GabrielBS-eng/Final-Project-automation-I-/3D design/ADDED/Renderings/sfdsf.JPG

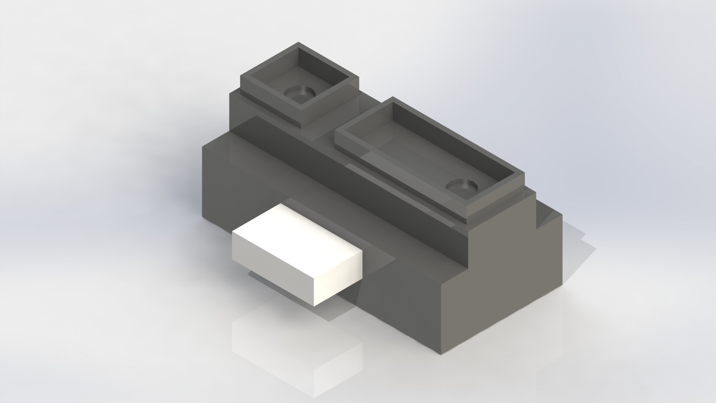
3D design/ADDED/Renderings/sfdsf.JPG
