GabrielBS-eng/Final-Project-automation-I-/MotorTFs/left_bw_step4s_0.05s_1.txt

% set_time: 50000
% delta t in s: 0.05
% START motor on: 1000
% END motor off: 5000
49	0.00
99	0.00
149	0.00
199	0.00
249	0.00
299	0.00
349	0.00
399	0.00
449	0.00
499	0.00
549	0.00
599	0.00
649	0.00
699	0.00
749	0.00
799	0.00
849	0.00
899	0.00
949	0.00
999	0.00
1049	96.97
1099	203.64
1149	244.85
1199	256.97
1249	264.24
1299	266.67
1349	271.52
1399	269.09
1449	271.52
1499	271.52
1549	271.52
1599	271.52
1649	271.52
1699	271.52
1748	271.52
1799	271.52
1849	271.52
1899	273.94
1949	271.52
1999	271.52
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
