GabrielBS-eng/Final-Project-automation-I-/IR/Infra re Object Detection.docx

1- Infra re Object Detection :

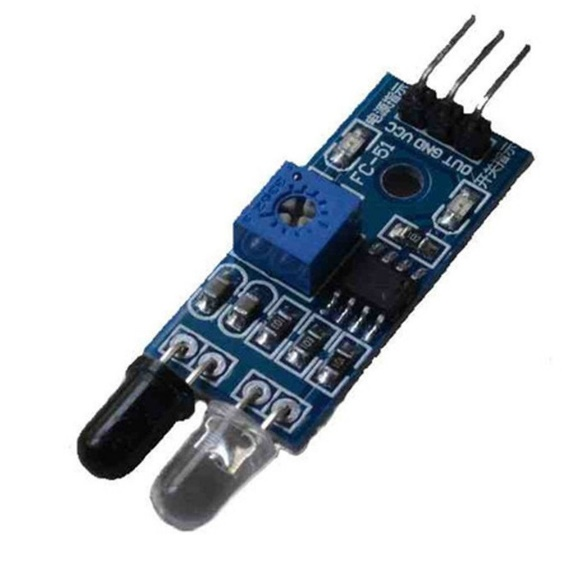
[picture p36: figure]

Infra Red Object detection only Range is 2:30 cm, Function to avoid colliding/Impact with other object and people

Specifications:

- Effective Range: 2:30 cm (Adjustable by potentiometer)
- Voltage Supply: 3.3: 5Vcc
- Detection Angle: 35°
- The comparator uses the LM393
- LED indicator (red---> power on, Green---> detection)
- Digital output

Pseudocode :

Sensor Pin X

Var to read Sensor XX

XX = reading of (X)

If (xx== High) Move to the other direction 5 cm

Example Pf three sensor Right , left and front Arduino Code :

int sensR= 8;

int sensF= 7;

int sensL= 9;

void setup ()

{

pinMode(sensL, INPUT);

pinMode(sensR, INPUT);

pinMode(sensF, INPUT);

}

sL= digitalRead(sensL);

sF= digitalRead(sensF);

sR= digitalRead(sensR);

void loop(){

sL= digitalRead(sensL);

sF= digitalRead(sensF);

sR= digitalRead(sensR);

if (sF== HIGH) {

backward(5);

}

if (sF== LOW) {

if (sL==HIGH && sR== LOW){

right(2.5);

}

if (sL== LOW && sR== HIGH){

left(2.5);

}

if (sL== HIGH && sR == HIGH){

left(2.5);

}

if (sL== LOW && sR== LOW){

forward();

}

}

2- Infra red Object detection and distance measuring

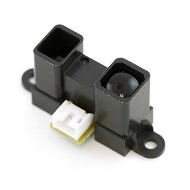
[picture p37: figure]
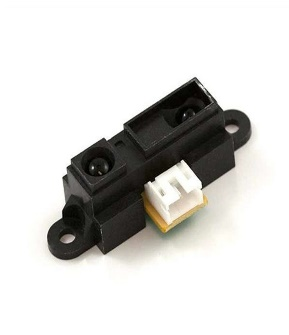
[picture p38: figure]

Function to avoid colliding and keeping or measuring distance also

Arduino Code :

int sensorPin = 0;

void setup()

{ Serial.begin(9600); }

void loop()

{

int val = analogRead(sensorPin); Serial.println(val); // read the distance

delay(100);

}

  a. varies from 2.8V at 15cm to 0.4V at 150cm.
  b. varies from 3.1V at 10cm to 0.4V at 80cm
3- Infra red Transmitter and receiver:

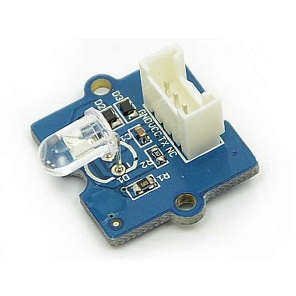
[picture p39: figure]
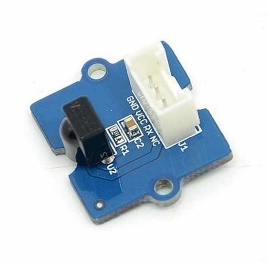
[picture p40: figure]
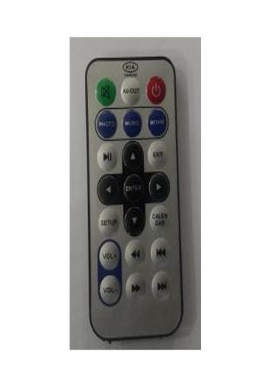
[picture p41: figure]
Infrared Remote Control (with Battery)
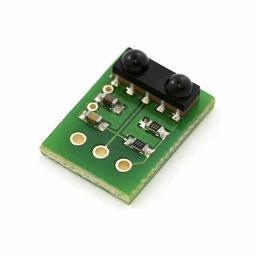
[picture p42: figure]
Infrared Receiver Board
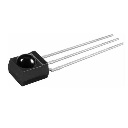
[picture p43: figure]
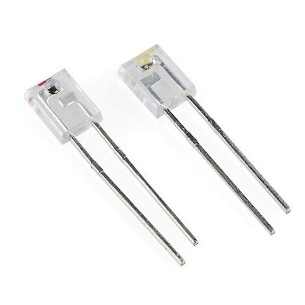
[picture p44: figure]

Function : Using remote control to connect and control the Robot within 10 meters range .

Code is via Library I already have the library with some examples

# 4- PIR Motion sensor module

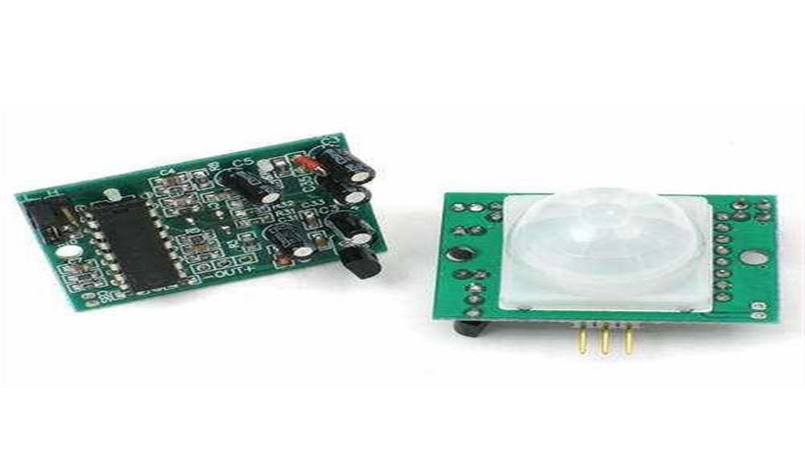
[picture p45: figure]
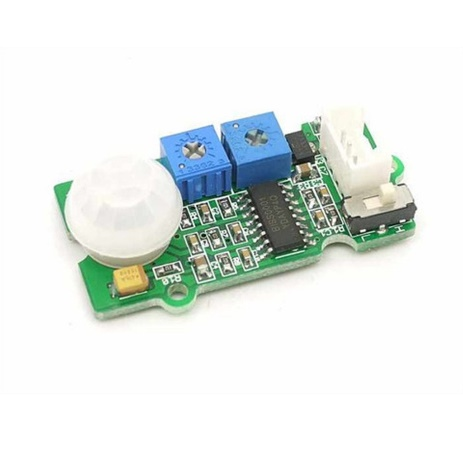
[picture p46: figure]

Only detect humans or alive Motion within 7 m

Same Code of the First IR , but with reversed function

Infra red Useful Applications in our robot
