GabrielBS-eng/Final-Project-automation-I-/3D design/4p-18650-cartridge.snapshot.1/4P.JPG

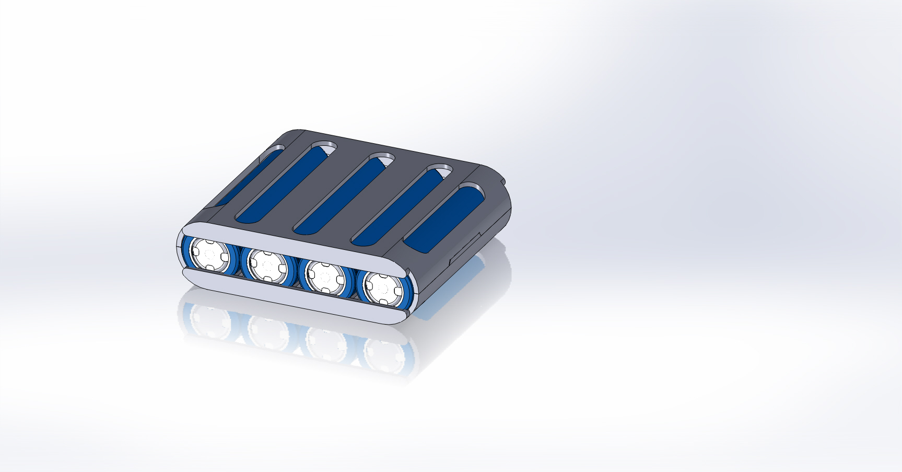
3D design/4p-18650-cartridge.snapshot.1/4P.JPG
