GabrielBS-eng/Final-Project-automation-I-/3D design/ADDED/Batt/Render/Batt.png

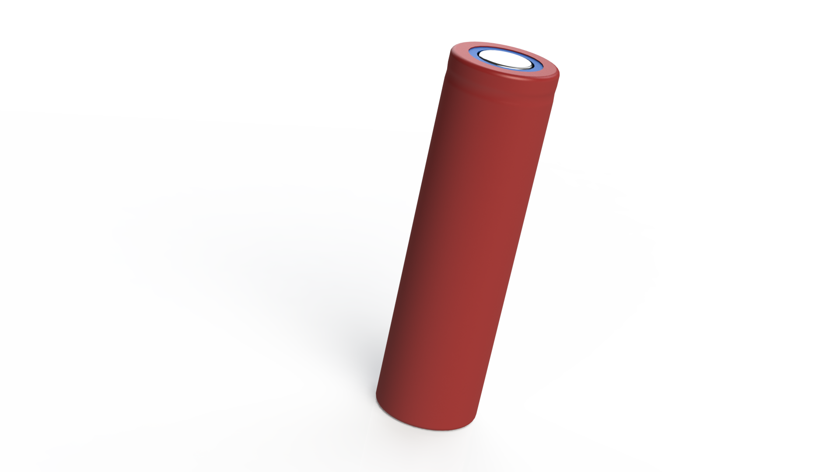
3D design/ADDED/Batt/Render/Batt.png
