GabrielBS-eng/Final-Project-automation-I-/3D design/ADDED/Batt_Pack/Render/Batt_Pack_Render.png

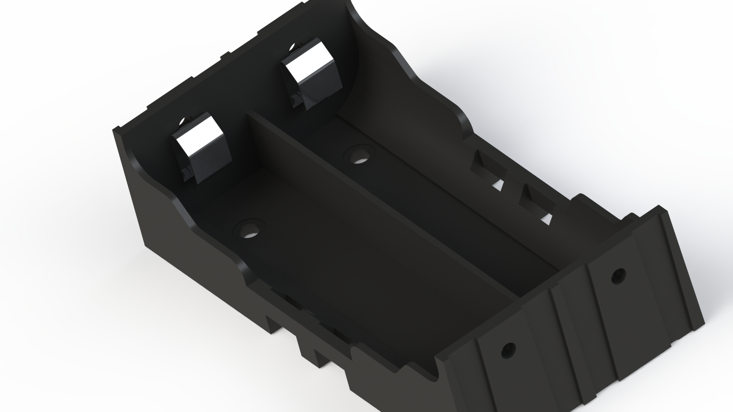
3D design/ADDED/Batt_Pack/Render/Batt_Pack_Render.png
