GabrielBS-eng/Final-Project-automation-I-/3D design/ADDED/Renderings/18650.jpg

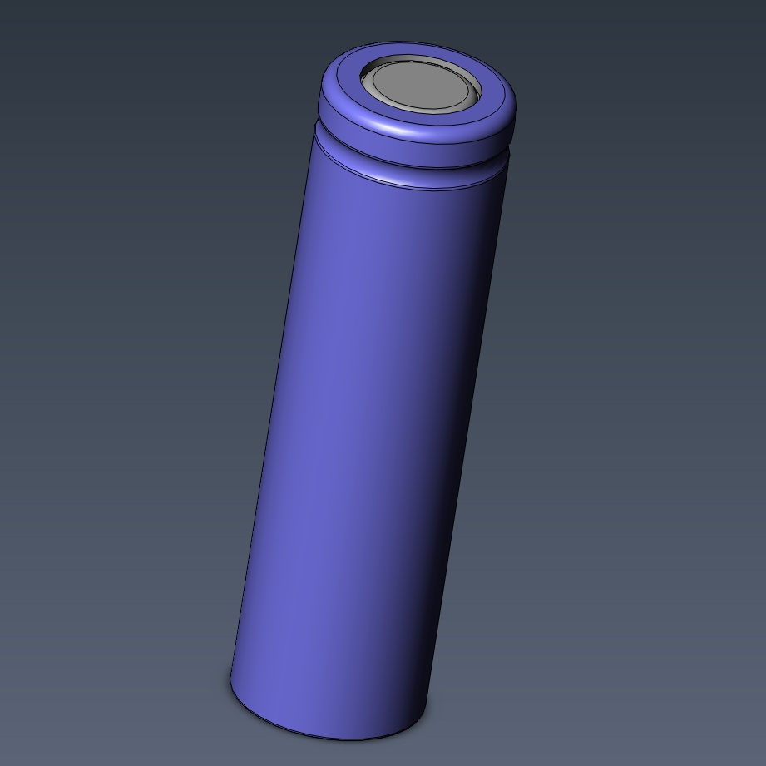
3D design/ADDED/Renderings/18650.jpg
