GabrielBS-eng/Final-Project-automation-I-/documentation/IMG_20171216_191746.jpg

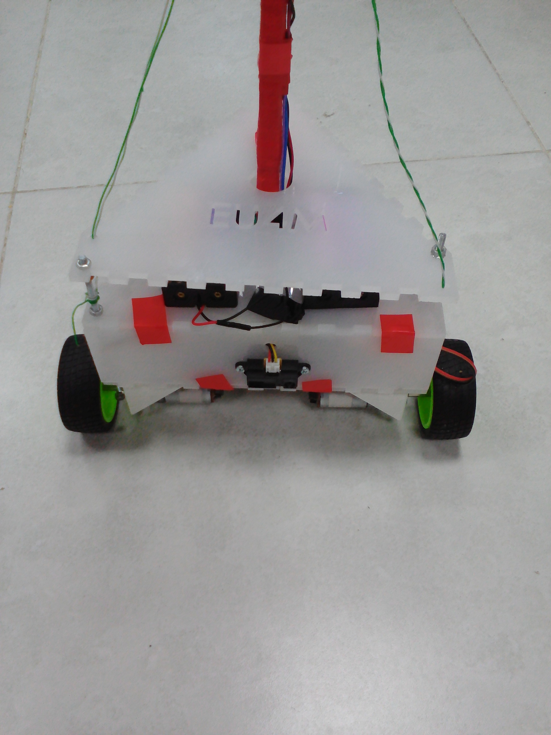
documentation/IMG_20171216_191746.jpg
