GabrielBS-eng/Final-Project-automation-I-/documentation/left_fw_tuner_discret.png

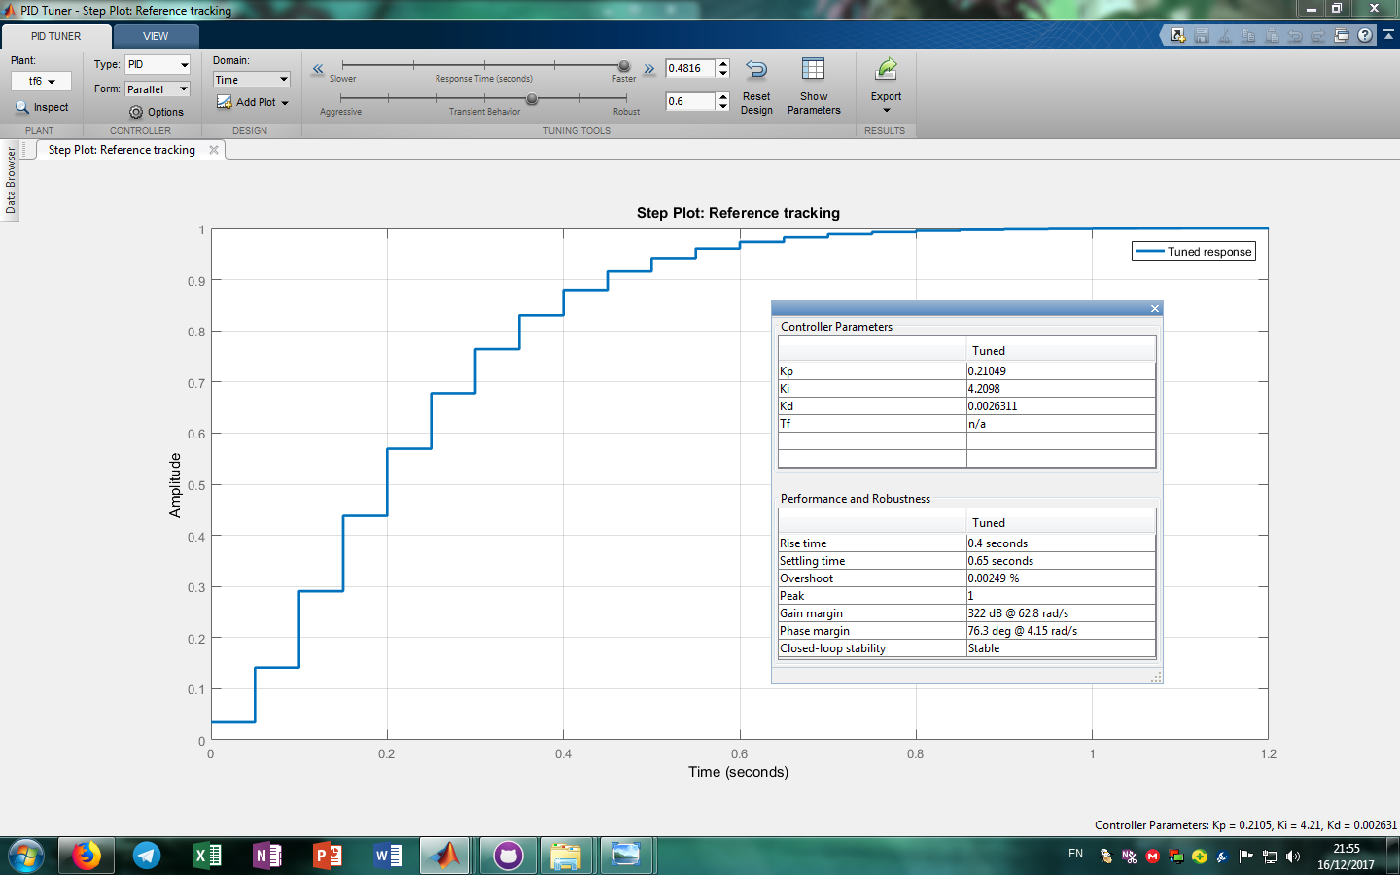
documentation/left_fw_tuner_discret.png
