GabrielBS-eng/Final-Project-automation-I-/documentation/Matlab FIG Comparison of All Tuned PID.jpg

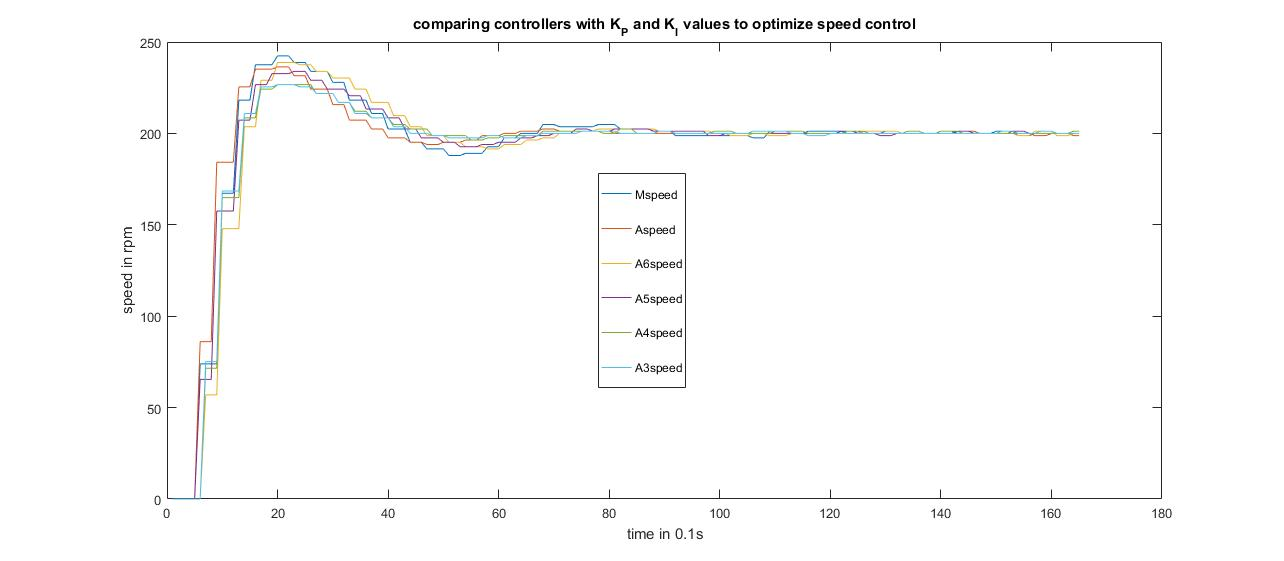
documentation/Matlab FIG Comparison of All Tuned PID.jpg
