GabrielBS-eng/Final-Project-automation-I-/MotorTFs/left_fw/left_fw_tuner.png

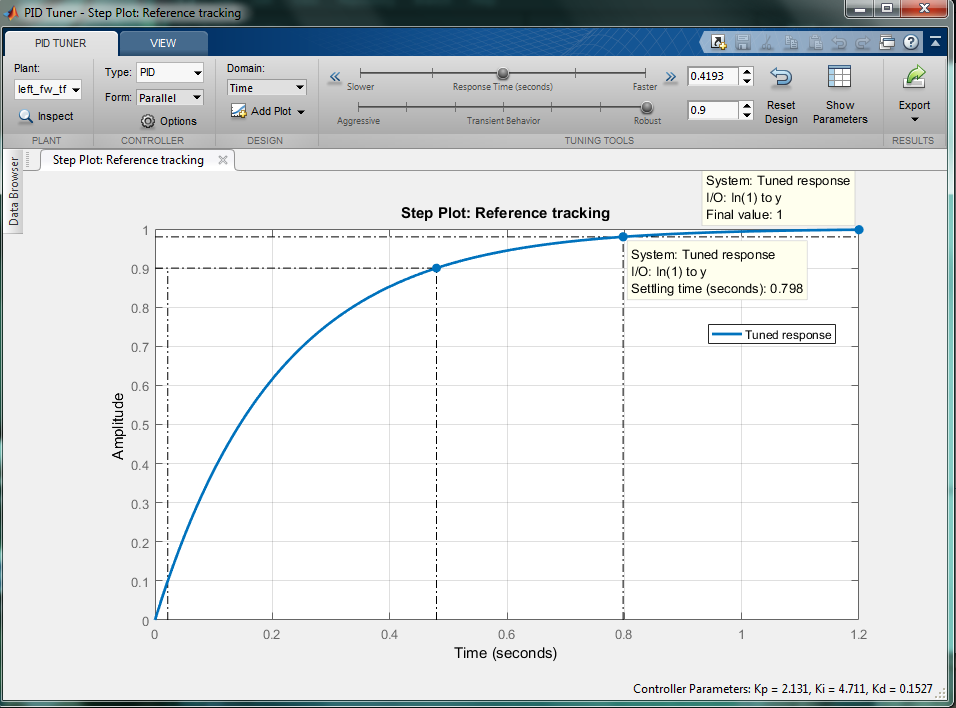
MotorTFs/left_fw/left_fw_tuner.png
