GabrielBS-eng/Final-Project-automation-I-/3D design/ADDED/Batt/3d/Batt_main.SLDPRT

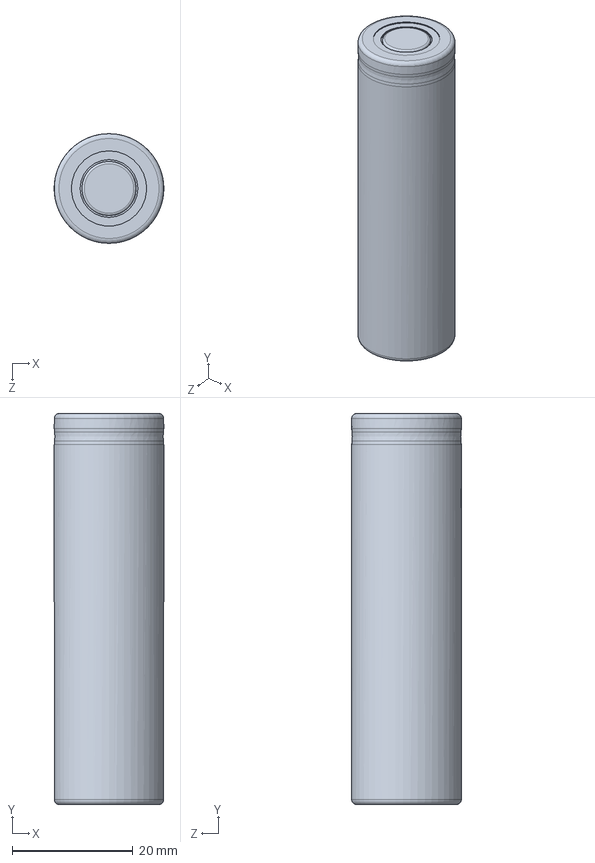
[picture p56: CAD file, 2017-12-15]
3D design/ADDED/Batt/3d/Batt_main.SLDPRT
18.2 x 64.9 x 18.2 mm
