GabrielBS-eng/Final-Project-automation-I-/3D design/ADDED/Batt_Pack/3d/Batt_Pack_Main.SLDPRT

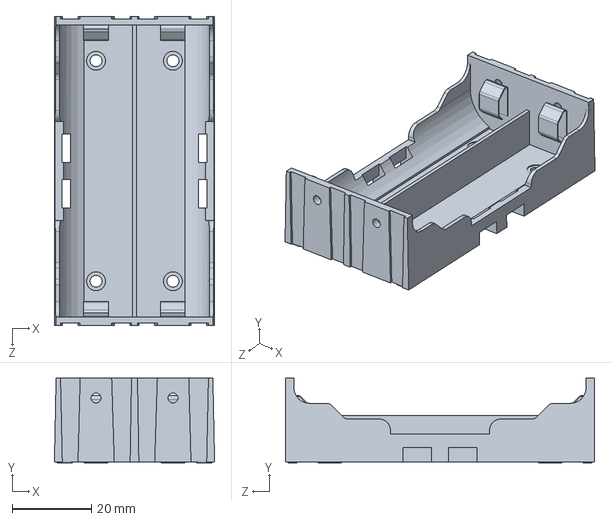
[picture p57: CAD file, 2017-12-15]
3D design/ADDED/Batt_Pack/3d/Batt_Pack_Main.SLDPRT
40.4 x 21.4 x 77.9 mm
