GabrielBS-eng/Final-Project-automation-I-/3D design/design draft 1/AssemFinalProject-2.SLDASM

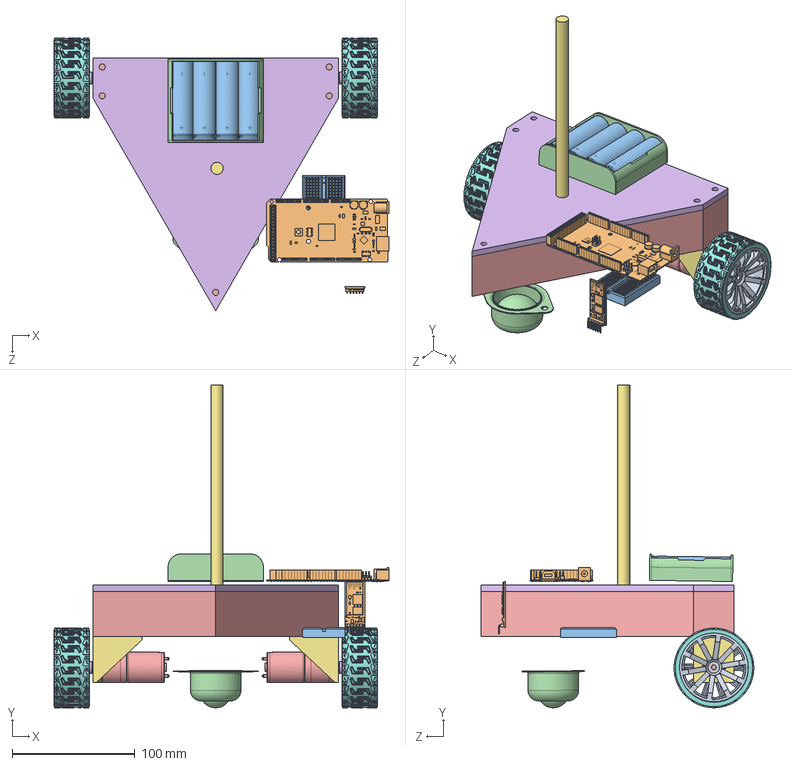
[picture p58: CAD file, 2017-12-10]
3D design/design draft 1/AssemFinalProject-2.SLDASM
273.0 x 262.9 x 222.2 mm
l298n1
ArduinoMega2560
New4P_TRAY
JGA25-372 24V Motor x 2
Coupler x 2
L HOLDER DC MOTOR x 2
65mm tire x 2
blue_wheel_frame x 2
hc05
MiniBreadboard
Flange-Mount Ball Transfer
triangular-base
second-base
Infusion-stand
