GabrielBS-eng/Final-Project-automation-I-/3D design/blue-wheel-for-hobby-robotics/blue_wheel_with_adapter.SLDASM

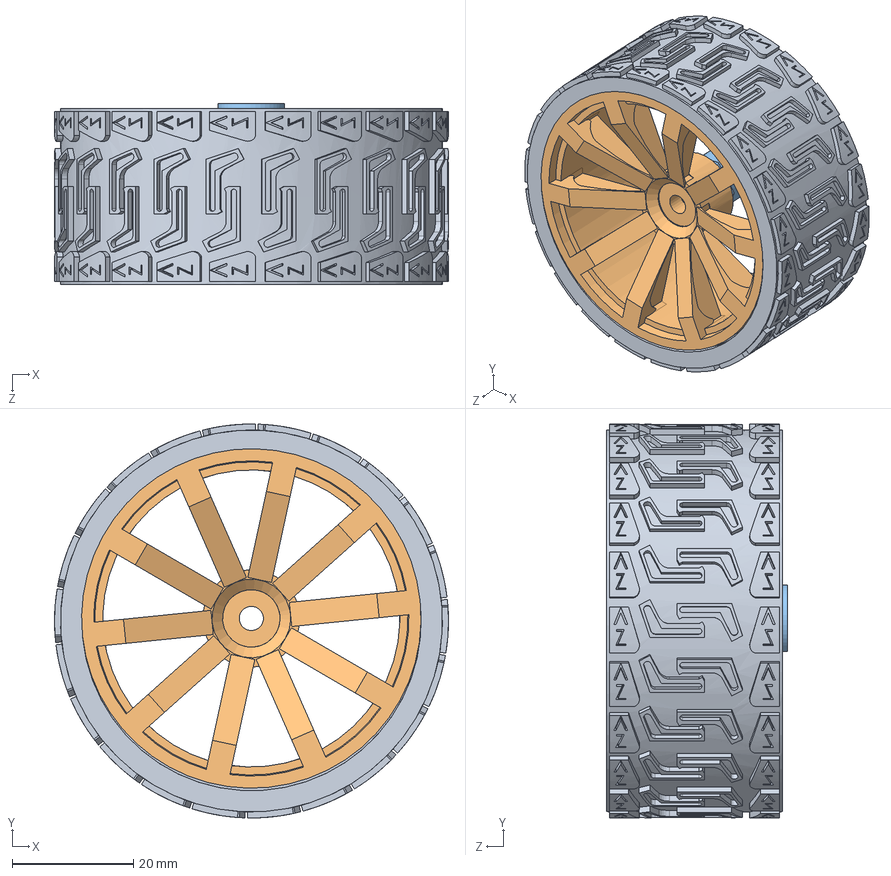
[picture p59: CAD file, 2017-12-12]
3D design/blue-wheel-for-hobby-robotics/blue_wheel_with_adapter.SLDASM
65.0 x 65.0 x 29.8 mm
65mm tire
blue_wheel_frame
motor_adapter
