GabrielBS-eng/Final-Project-automation-I-/3D design/ADDED/Assembly File_R02.SLDASM

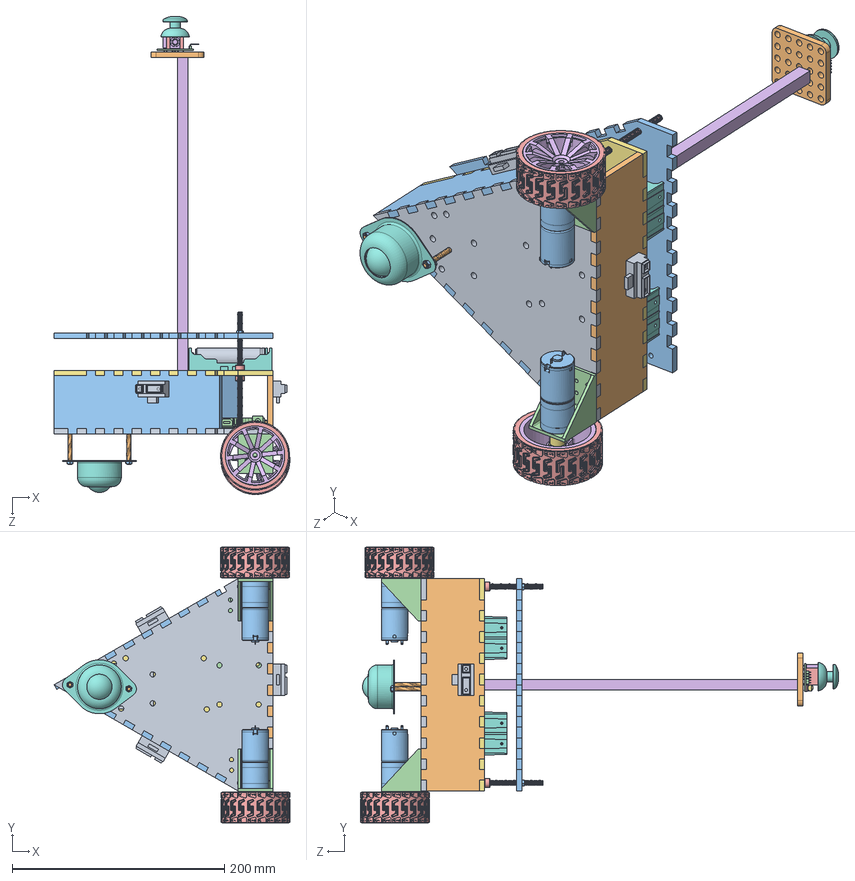
[picture p60: CAD file, 2017-12-15]
3D design/ADDED/Assembly File_R02.SLDASM
222.2 x 260.0 x 450.6 mm
triangular base 1
the back wall
Walls x 2
ArduinoMega2560
65mm tire x 2
blue_wheel_frame x 2
motor_adapter x 2
Flange-Mount Ball Transfer
l298n1
MiniBreadboard
JGA25-372 24V Motor x 2
L HOLDER DC MOTOR x 2
M5 x 50mm CAPHEAD BOLT x 4
IV Stand
1st Layer
Batt_Pack_Main x 2
Batt_main x 4
Addational useful layer 2
Top layer
board
potentiometer x 2
tactileswitch-short
joystickhead
sharp 2y0a21 f 21 x 3
M4 x 50mm CAPHEAD BOLT x 2
hex nut style 1_am x 4
