GabrielBS-eng/Final-Project-automation-I-/3D design/blue-wheel-for-hobby-robotics/blue_wheel_v1.SLDASM

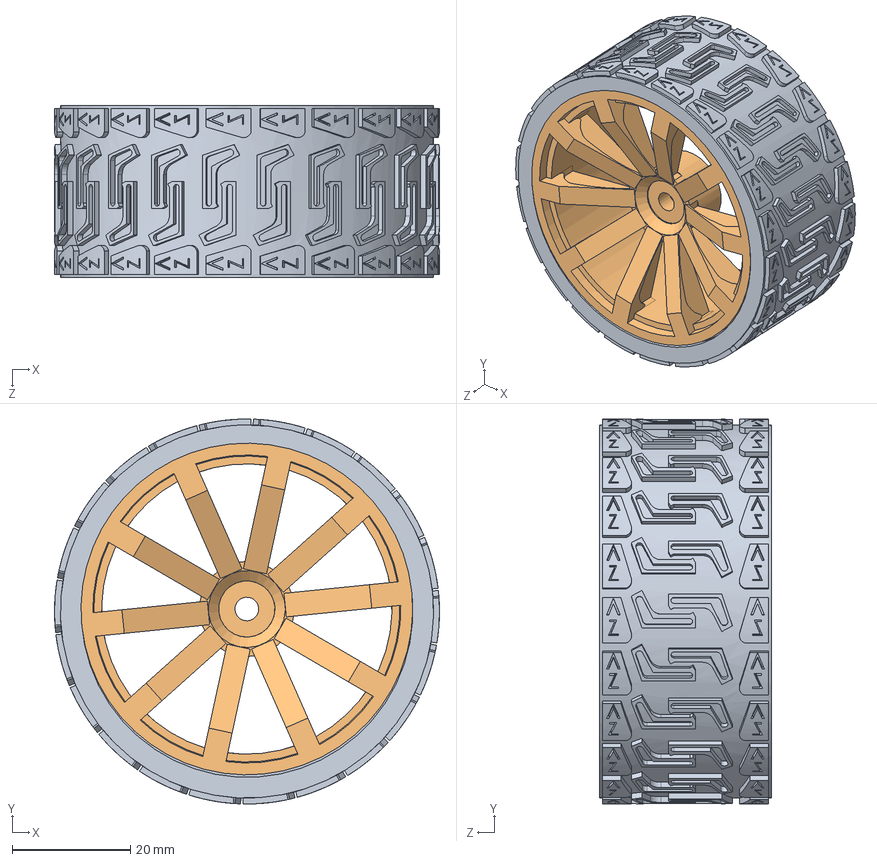
[picture p61: CAD file, 2017-12-09]
3D design/blue-wheel-for-hobby-robotics/blue_wheel_v1.SLDASM
65.0 x 65.0 x 29.0 mm
65mm tire
blue_wheel_frame
