GabrielBS-eng/Final-Project-automation-I-/3D design/ADDED/Joystick/Thumb Joystick.SLDASM

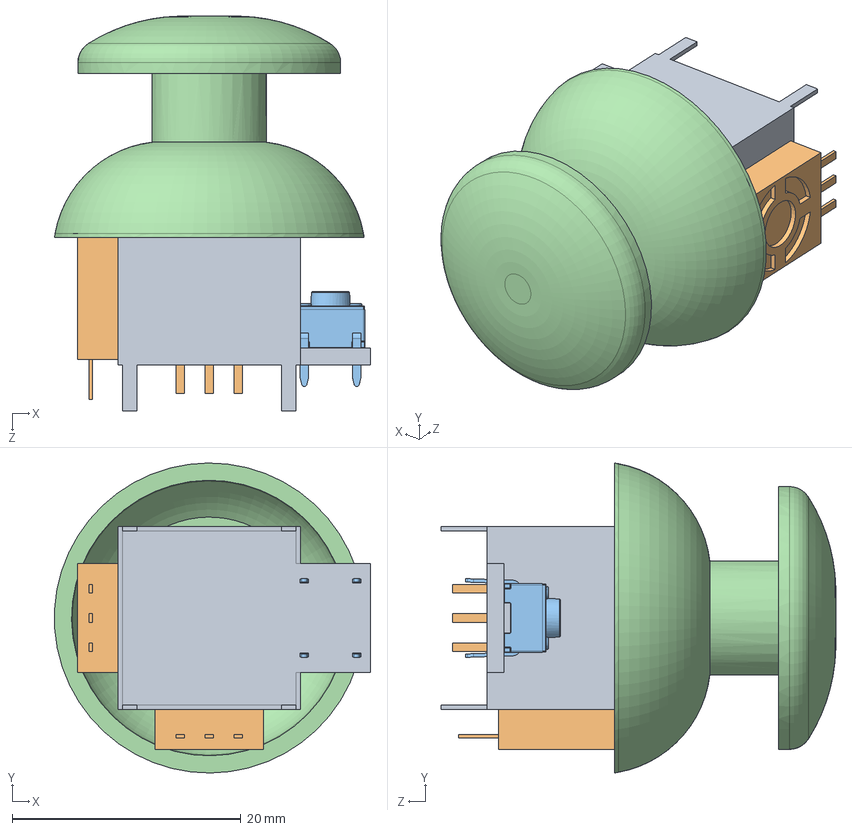
[picture p63: CAD file, 2017-12-15]
3D design/ADDED/Joystick/Thumb Joystick.SLDASM
27.6 x 27.1 x 34.5 mm
potentiometer x 2
tactileswitch-short
joystickhead
