GabrielBS-eng/Final-Project-automation-I-/3D design/ADDED/Joystick/Joystick assembly.STEP

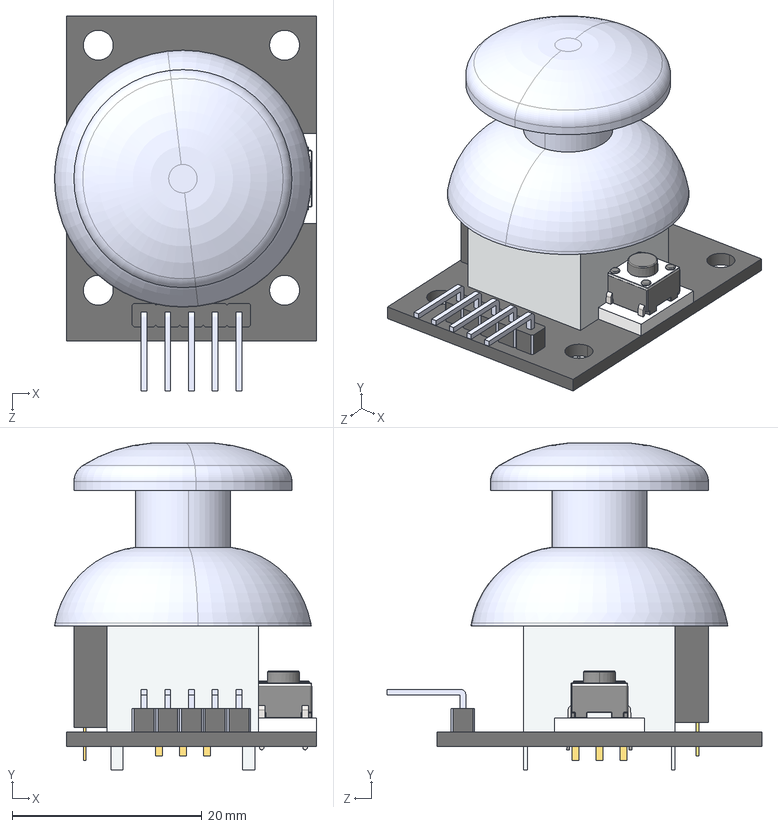
[picture p64: CAD file, 2017-12-15]
3D design/ADDED/Joystick/Joystick assembly.STEP
27.7 x 34.5 x 39.5 mm
board
potentiometer___ x 2
tactileswitch-short
joystickhead___
