GabrielBS-eng/Final-Project-automation-I-/3D design/4p-18650-cartridge.snapshot.1/4P.STEP

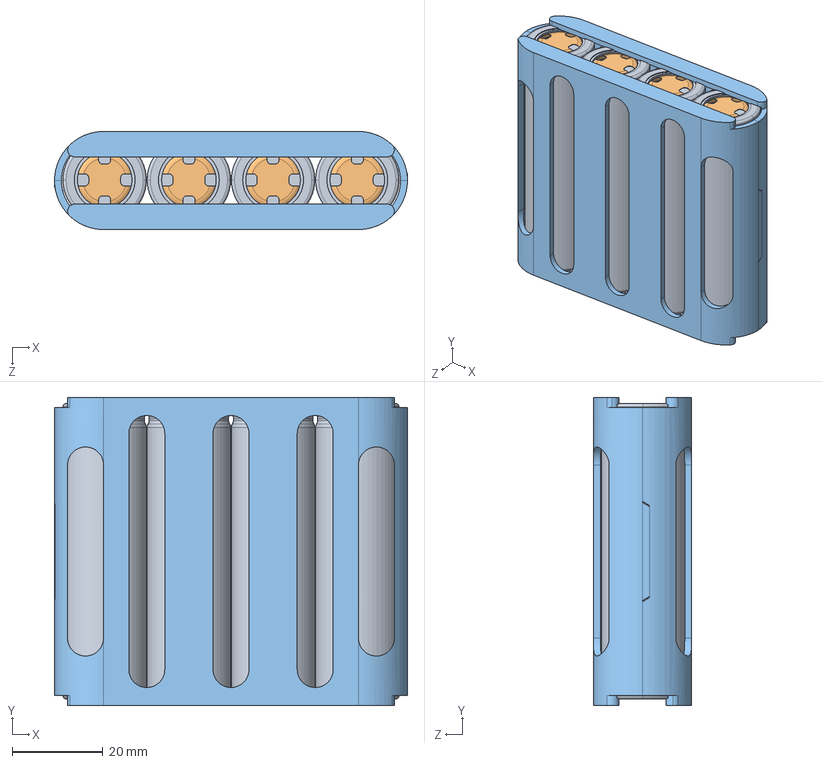
[picture p65: CAD file, 2017-12-09]
3D design/4p-18650-cartridge.snapshot.1/4P.STEP
77.7 x 67.8 x 21.6 mm
4P_TRAY x 2
