GabrielBS-eng/Final-Project-automation-I-/3D design/ADDED/Joystick/tactileswitch-short.SLDPRT

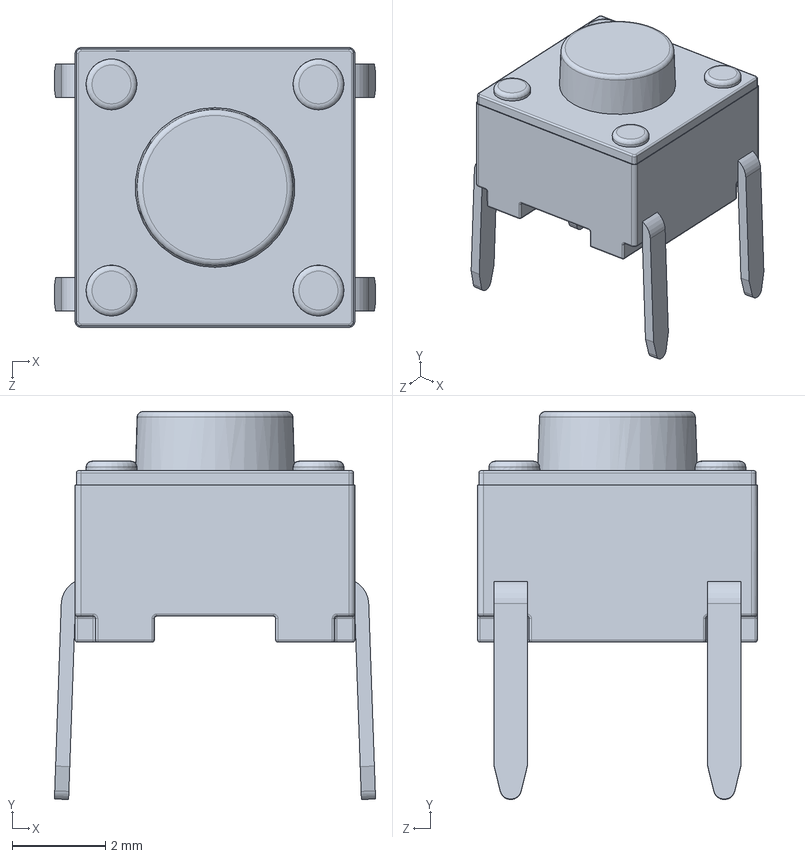
[picture p66: CAD file, 2017-12-15]
3D design/ADDED/Joystick/tactileswitch-short.SLDPRT
6.89 x 8.33 x 6.01 mm
