GabrielBS-eng/Final-Project-automation-I-/3D design/arduino-mega-2560-3.snapshot.1/ArduinoMega2560/ArduinoMega2560.SLDPRT

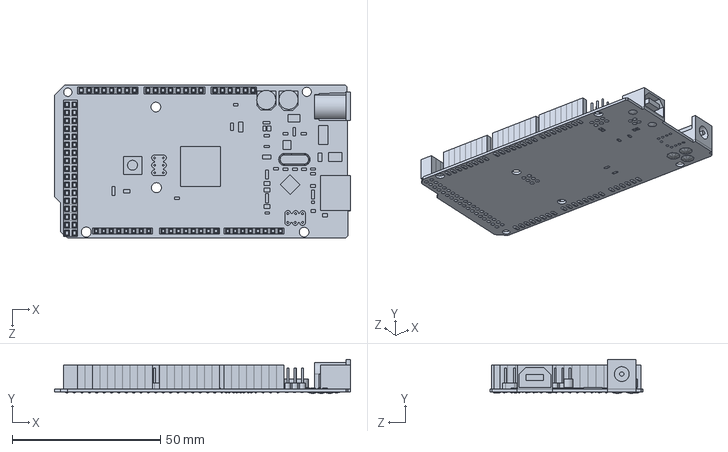
[picture p67: CAD file, 2017-12-09]
3D design/arduino-mega-2560-3.snapshot.1/ArduinoMega2560/ArduinoMega2560.SLDPRT
100.0 x 11.6 x 51.6 mm
