GabrielBS-eng/Final-Project-automation-I-/3D design/blue-wheel-for-hobby-robotics/motor_adapter.SLDPRT

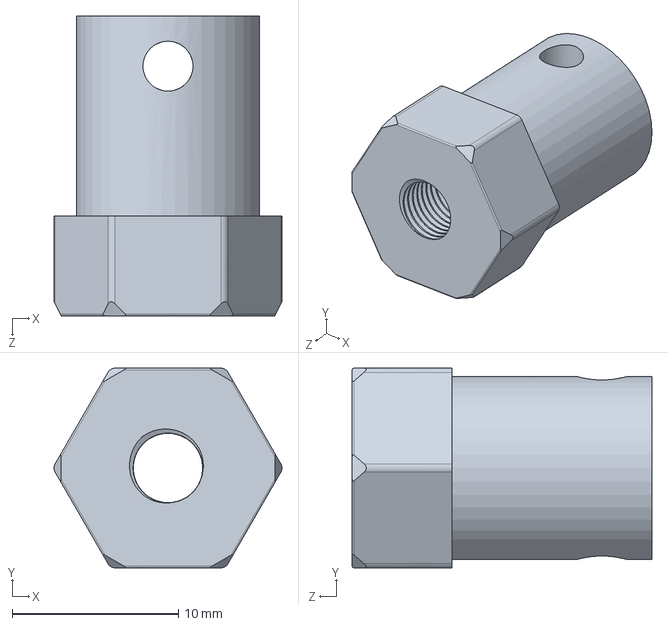
[picture p68: CAD file, 2017-12-12]
3D design/blue-wheel-for-hobby-robotics/motor_adapter.SLDPRT
13.7 x 12.0 x 18.0 mm
