GabrielBS-eng/Final-Project-automation-I-/3D design/Bluetooth module/hc05.SLDPRT

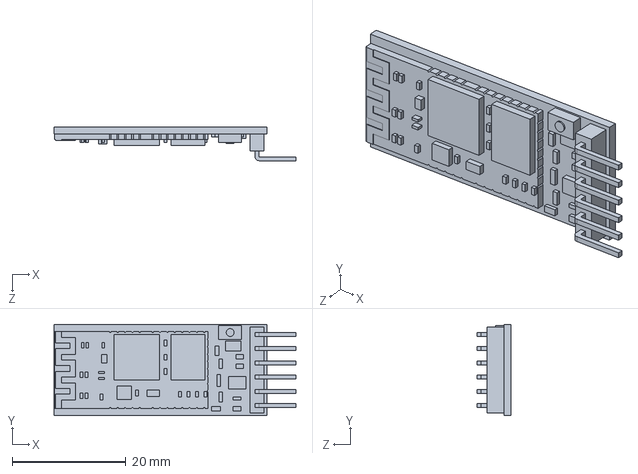
[picture p69: CAD file, 2017-12-09]
3D design/Bluetooth module/hc05.SLDPRT
42.6 x 16.1 x 5.90 mm
