GabrielBS-eng/Final-Project-automation-I-/3D design/Caster Ball Wheel/Flange-Mount Ball Transfer.SLDPRT

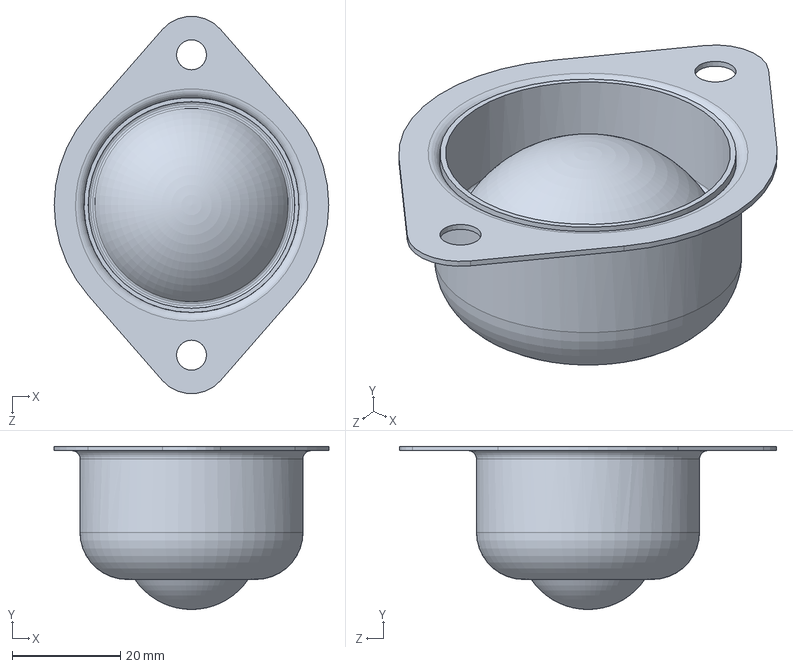
[picture p70: CAD file, 2017-12-09]
3D design/Caster Ball Wheel/Flange-Mount Ball Transfer.SLDPRT
50.8 x 30.2 x 69.7 mm
