GabrielBS-eng/Final-Project-automation-I-/3D design/Final Design/DXF/Addational useful layer 2 2x.DXF

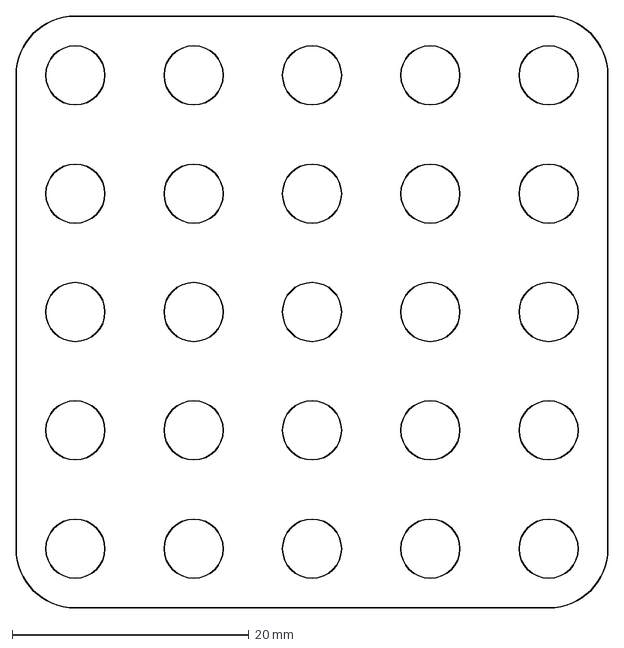
[picture p71: CAD file, 2017-12-12]
3D design/Final Design/DXF/Addational useful layer 2 2x.DXF
50.0 x 50.0 mm
