GabrielBS-eng/Final-Project-automation-I-/3D design/l298n-5.snapshot.2/l298n1.SLDPRT

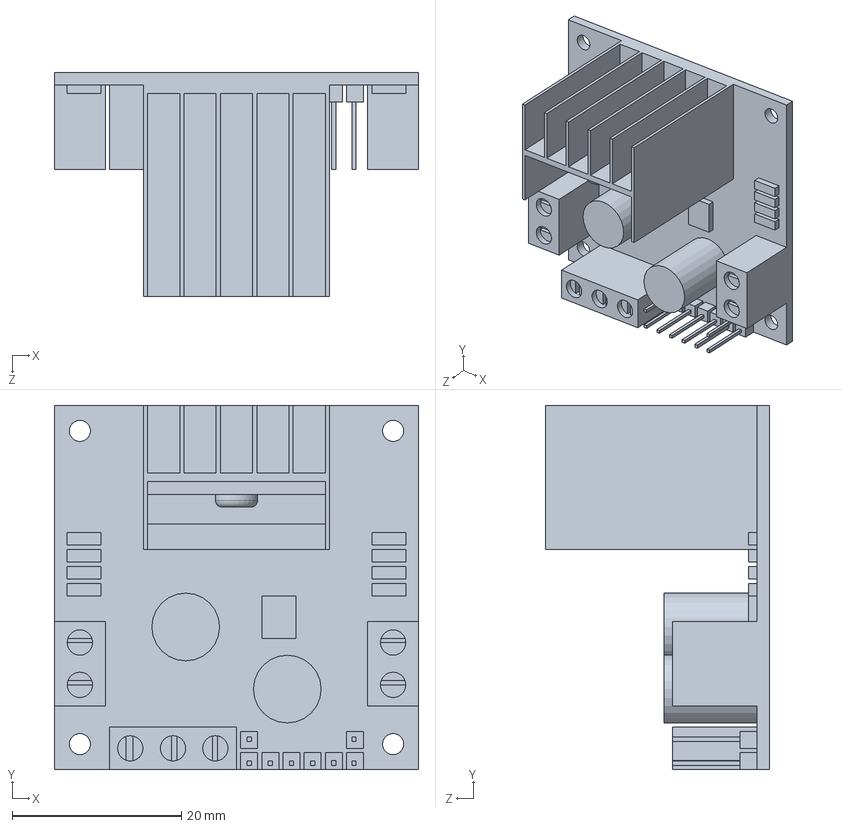
[picture p73: CAD file, 2017-12-09]
3D design/l298n-5.snapshot.2/l298n1.SLDPRT
43.0 x 43.0 x 26.5 mm
