GabrielBS-eng/Final-Project-automation-I-/3D design/mini-breadboard.snapshot.2/MiniBreadboard.SLDPRT

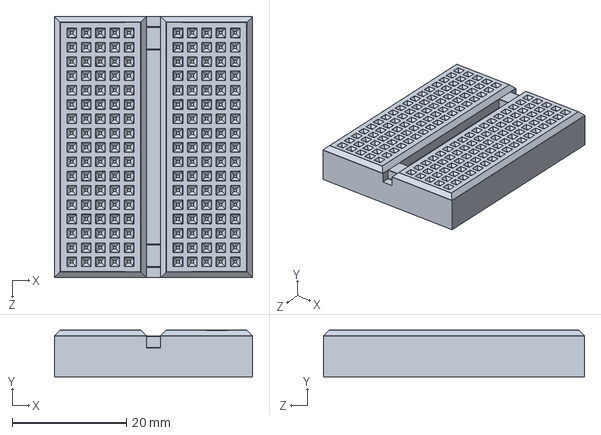
[picture p74: CAD file, 2017-12-09]
3D design/mini-breadboard.snapshot.2/MiniBreadboard.SLDPRT
34.6 x 8.15 x 45.6 mm
