GabrielBS-eng/Final-Project-automation-I-/3D design/New Motor with base/Coupler.SLDPRT

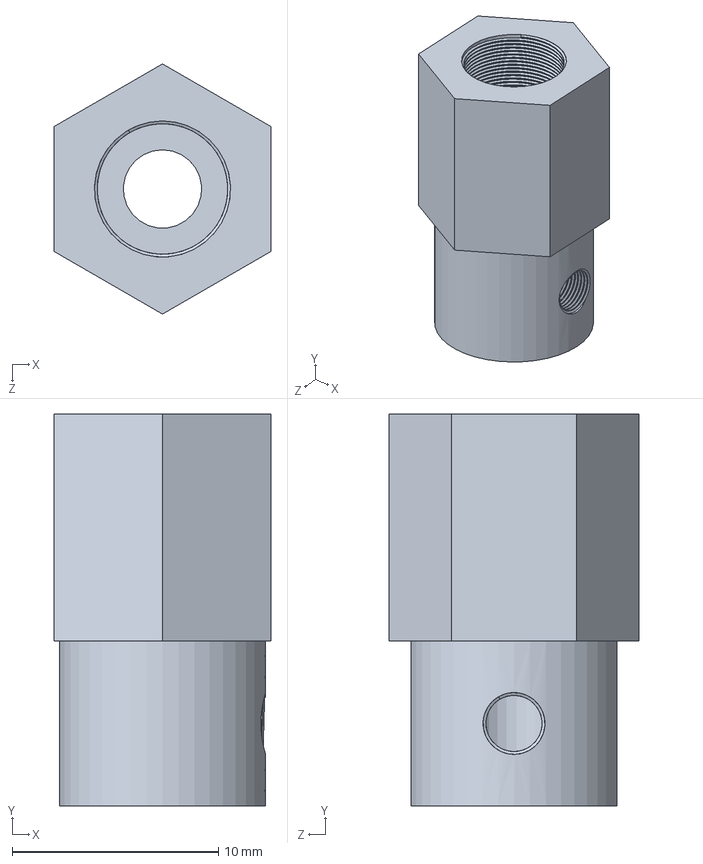
[picture p75: CAD file, 2017-12-12]
3D design/New Motor with base/Coupler.SLDPRT
10.5 x 19.0 x 12.1 mm
