GabrielBS-eng/Final-Project-automation-I-/3D design/ADDED/IV Stand.SLDPRT

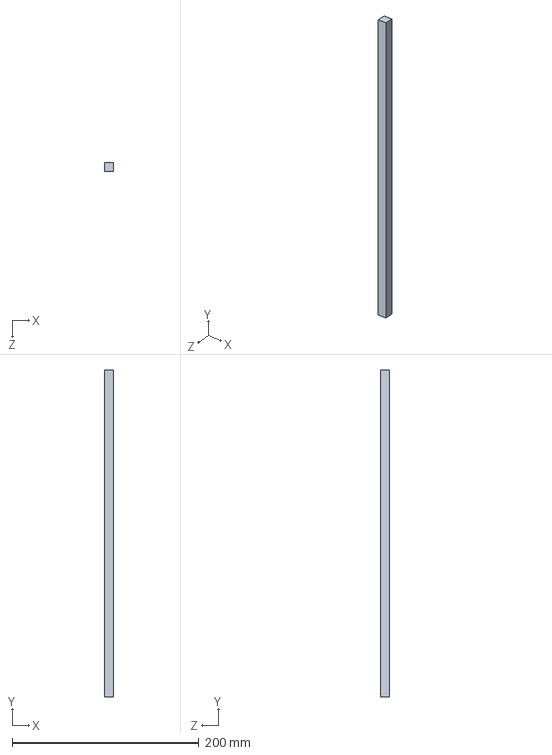
[picture p76: CAD file, 2017-12-15]
3D design/ADDED/IV Stand.SLDPRT
10.0 x 350.0 x 10.0 mm
