GabrielBS-eng/Final-Project-automation-I-/3D design/ADDED/Joystick/board.SLDPRT

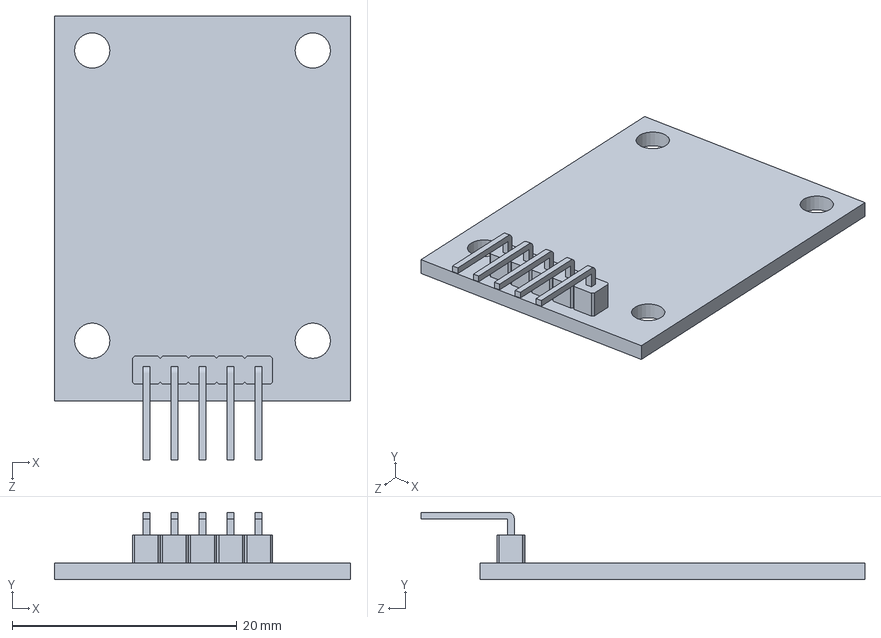
[picture p77: CAD file, 2017-12-15]
3D design/ADDED/Joystick/board.SLDPRT
26.4 x 6.01 x 39.5 mm
