GabrielBS-eng/Final-Project-automation-I-/3D design/Final Design/Addational useful laer.SLDPRT

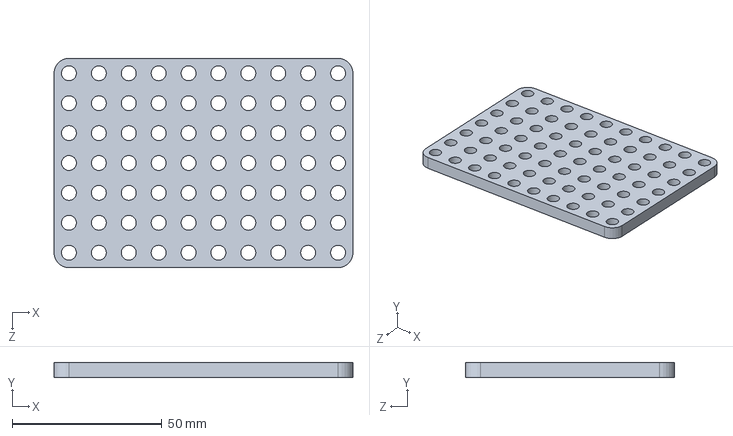
[picture p78: CAD file, 2017-12-12]
3D design/Final Design/Addational useful laer.SLDPRT
100.0 x 5.00 x 70.0 mm
