GabrielBS-eng/Final-Project-automation-I-/3D design/Final Design/DXF/triangular base.DXF

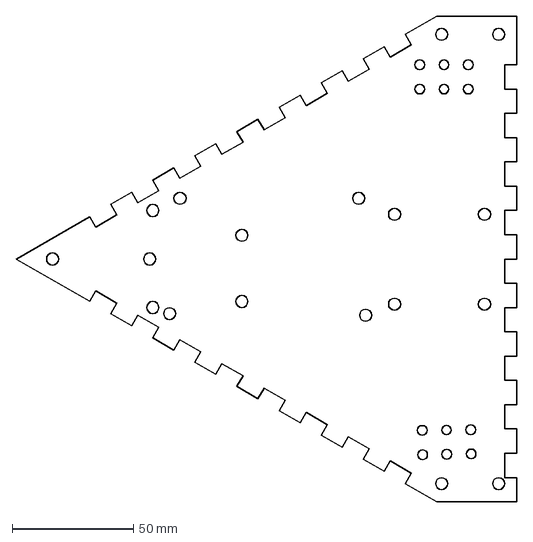
[picture p79: CAD file, 2017-12-12]
3D design/Final Design/DXF/triangular base.DXF
206.2 x 200.0 mm
