GabrielBS-eng/Final-Project-automation-I-/3D design/New Motor with base/JGA25-372 24V Motor.SLDPRT

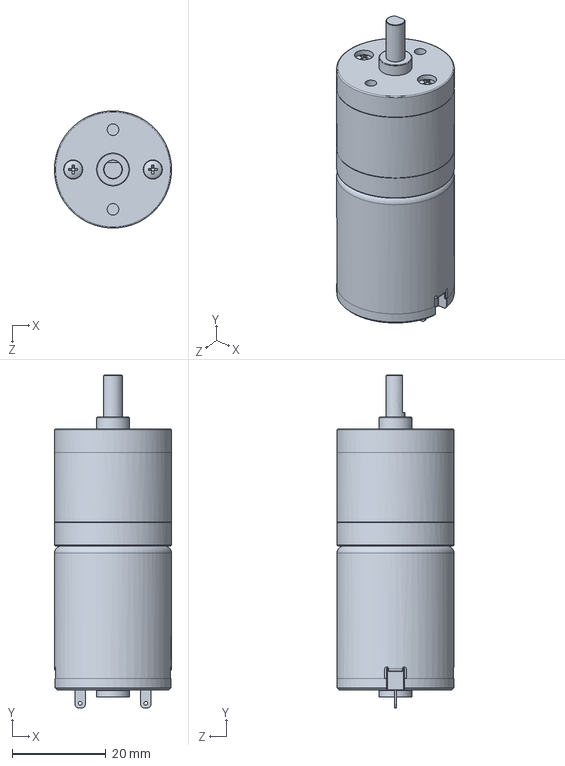
[picture p80: CAD file, 2017-12-12]
3D design/New Motor with base/JGA25-372 24V Motor.SLDPRT
25.0 x 71.1 x 25.0 mm
