GabrielBS-eng/Final-Project-automation-I-/3D design/4p-18650-cartridge.snapshot.1/New4P_TRAY.sldprt

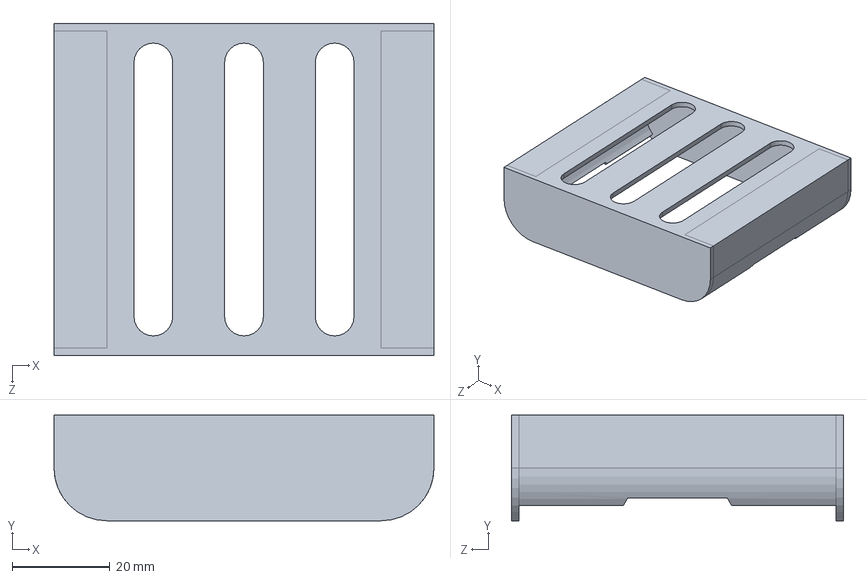
[picture p81: CAD file, 2017-12-09]
3D design/4p-18650-cartridge.snapshot.1/New4P_TRAY.sldprt
77.7 x 21.6 x 67.8 mm
