GabrielBS-eng/Final-Project-automation-I-/3D design/ADDED/Joystick/body.SLDPRT

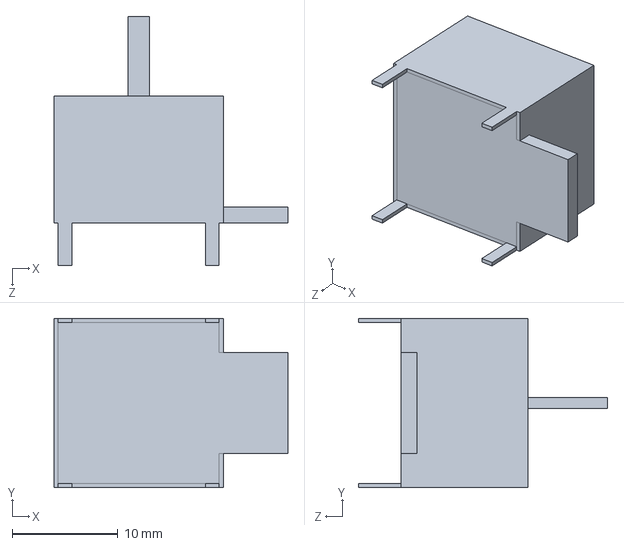
[picture p82: CAD file, 2017-12-15]
3D design/ADDED/Joystick/body.SLDPRT
22.1 x 16.0 x 23.5 mm
