GabrielBS-eng/Final-Project-automation-I-/3D design/Final Design/Addational useful layer 2.SLDPRT

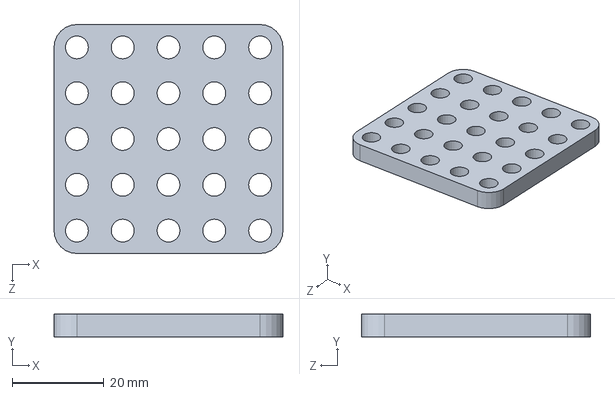
[picture p83: CAD file, 2017-12-12]
3D design/Final Design/Addational useful layer 2.SLDPRT
50.0 x 5.00 x 50.0 mm
