GabrielBS-eng/Final-Project-automation-I-/3D design/Final Design/DXF/Top layer EU4M.DXF

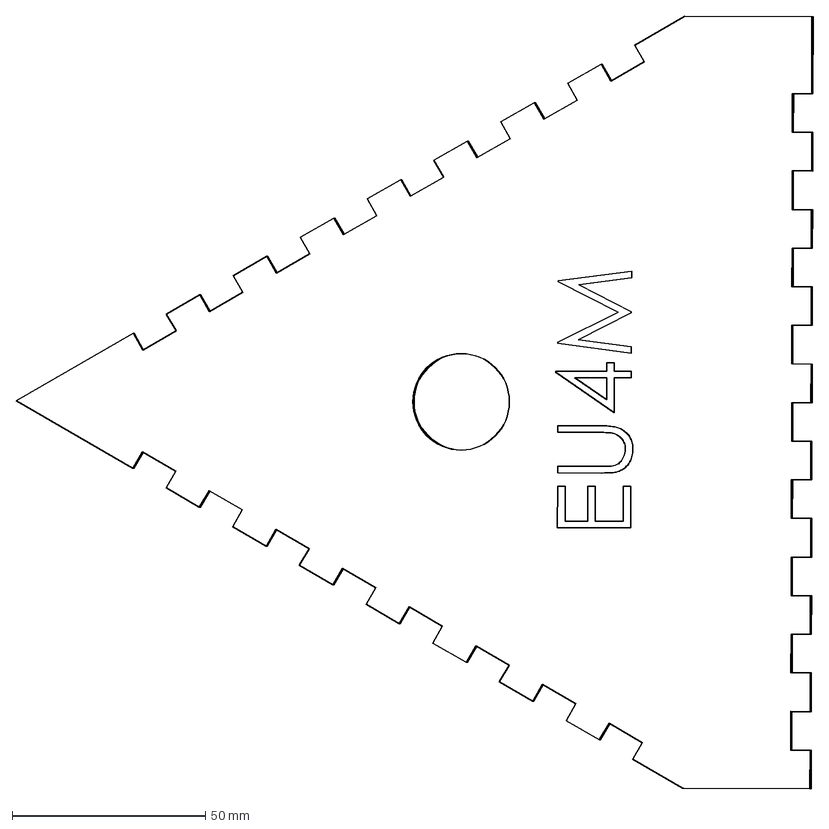
[picture p84: CAD file, 2017-12-12]
3D design/Final Design/DXF/Top layer EU4M.DXF
206.4 x 200.1 mm
