GabrielBS-eng/Final-Project-automation-I-/3D design/New Motor with base/L HOLDER DC MOTOR.SLDPRT

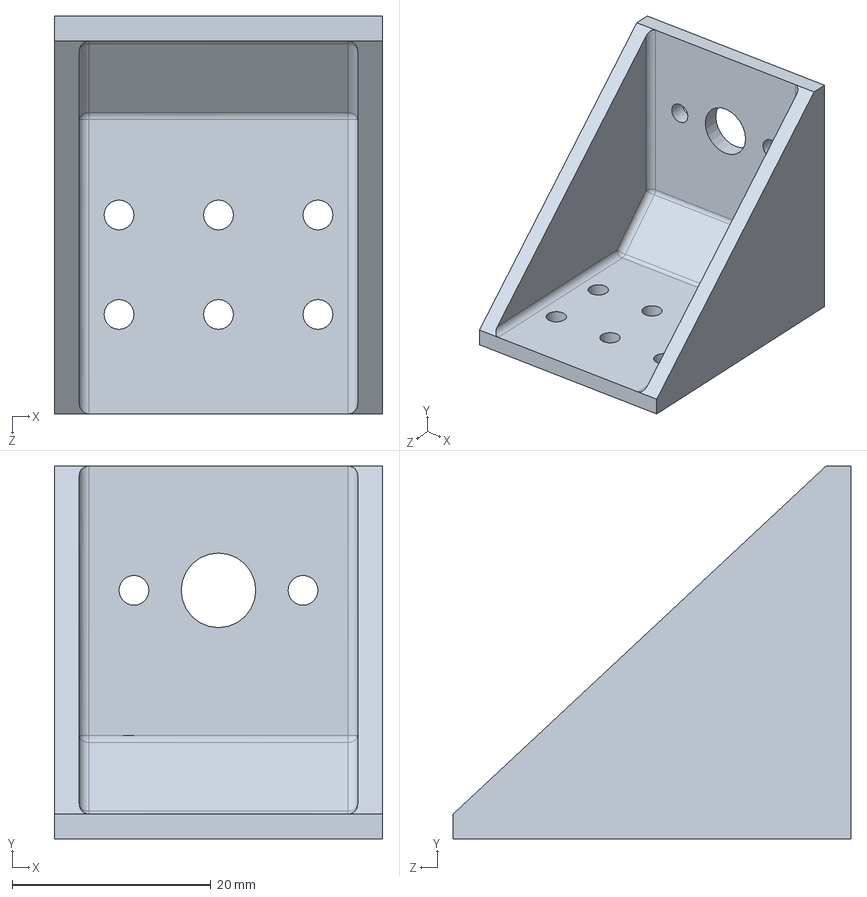
[picture p85: CAD file, 2017-12-12]
3D design/New Motor with base/L HOLDER DC MOTOR.SLDPRT
33.0 x 37.5 x 40.0 mm
