GabrielBS-eng/Final-Project-automation-I-/3D design/ADDED/Joystick/potentiometer.SLDPRT

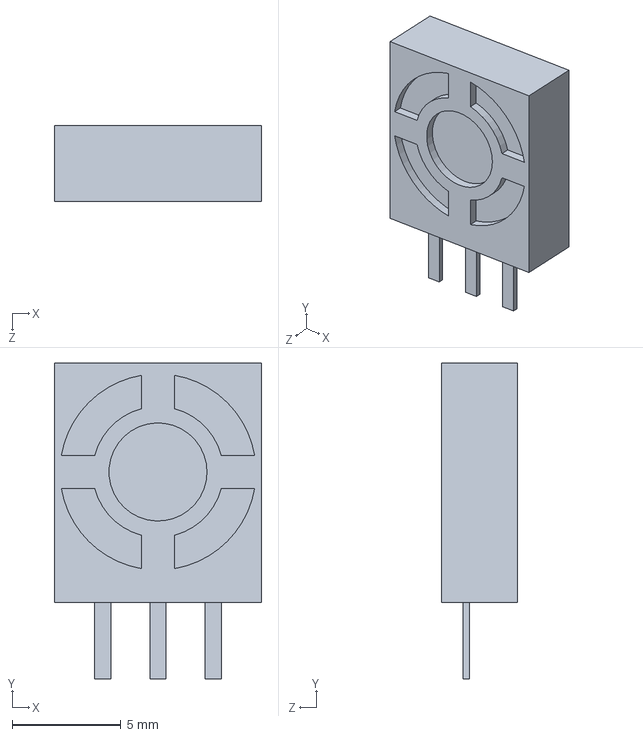
[picture p86: CAD file, 2017-12-15]
3D design/ADDED/Joystick/potentiometer.SLDPRT
9.50 x 14.5 x 3.50 mm
