GabrielBS-eng/Final-Project-automation-I-/3D design/blue-wheel-for-hobby-robotics/blue_wheel_frame.SLDPRT

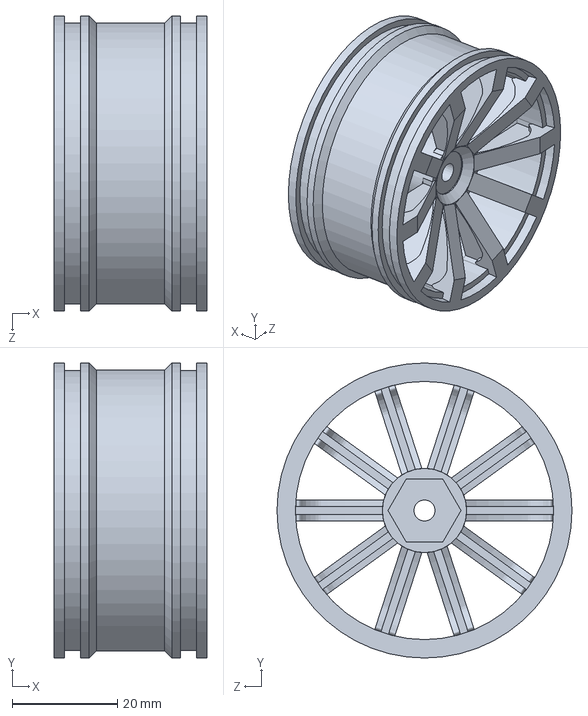
[picture p87: CAD file, 2017-12-09]
3D design/blue-wheel-for-hobby-robotics/blue_wheel_frame.SLDPRT
29.0 x 56.0 x 56.0 mm
