GabrielBS-eng/Final-Project-automation-I-/3D design/Final Design/DXF/Walls 2x.DXF

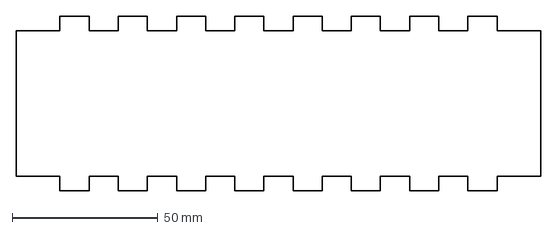
[picture p88: CAD file, 2017-12-12]
3D design/Final Design/DXF/Walls 2x.DXF
180.0 x 60.0 mm
