GabrielBS-eng/Final-Project-automation-I-/3D design/Final Design/the back wall.SLDPRT

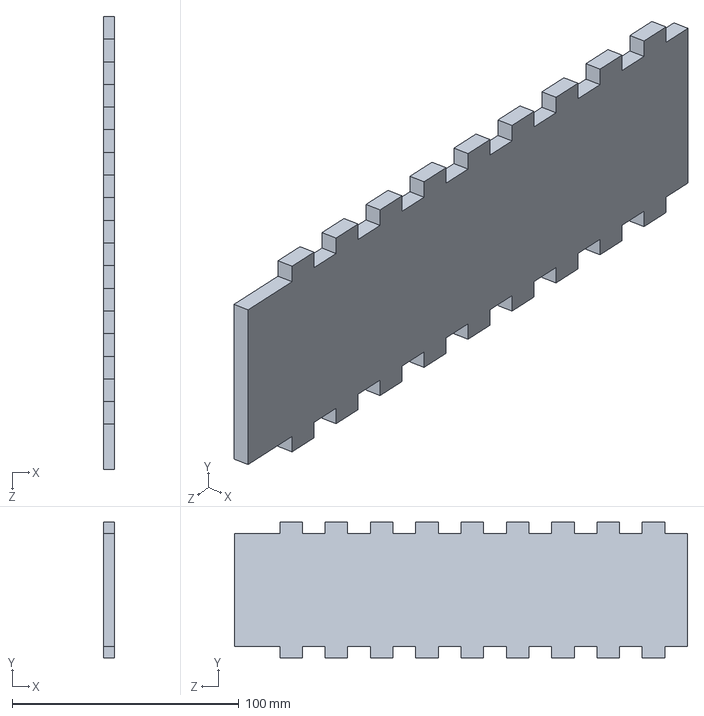
[picture p89: CAD file, 2017-12-12]
3D design/Final Design/the back wall.SLDPRT
5.00 x 60.0 x 200.0 mm
