GabrielBS-eng/Final-Project-automation-I-/3D design/ADDED/Joystick/joystickhead.SLDPRT

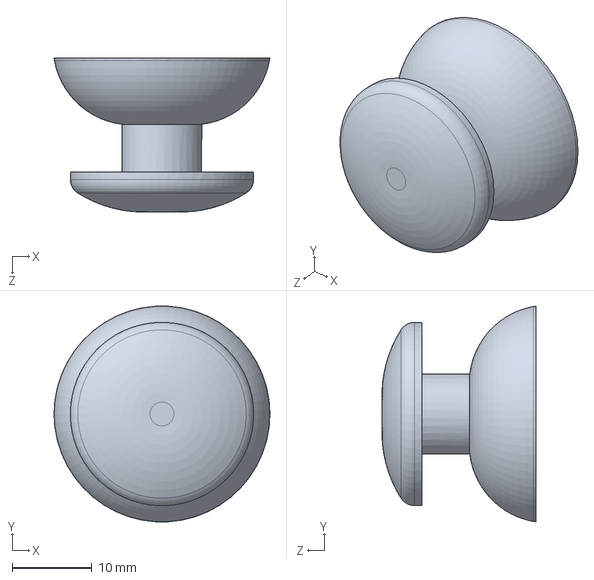
[picture p90: CAD file, 2017-12-15]
3D design/ADDED/Joystick/joystickhead.SLDPRT
27.1 x 27.1 x 19.3 mm
