GabrielBS-eng/Final-Project-automation-I-/3D design/ADDED/sharp 2y0a21 f 21.SLDPRT

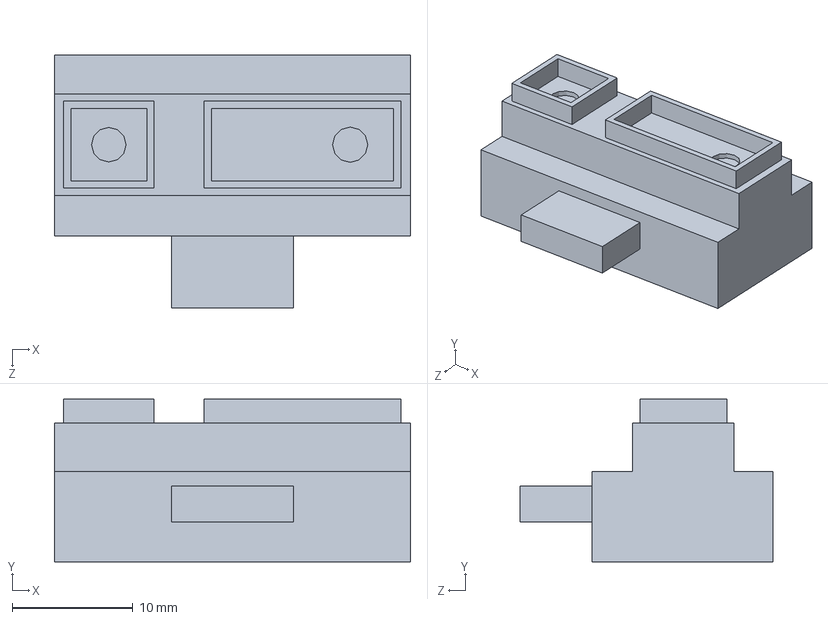
[picture p91: CAD file, 2017-12-15]
3D design/ADDED/sharp 2y0a21 f 21.SLDPRT
29.5 x 13.5 x 21.0 mm
