GabrielBS-eng/Final-Project-automation-I-/3D design/blue-wheel-for-hobby-robotics/65mm tire.SLDPRT

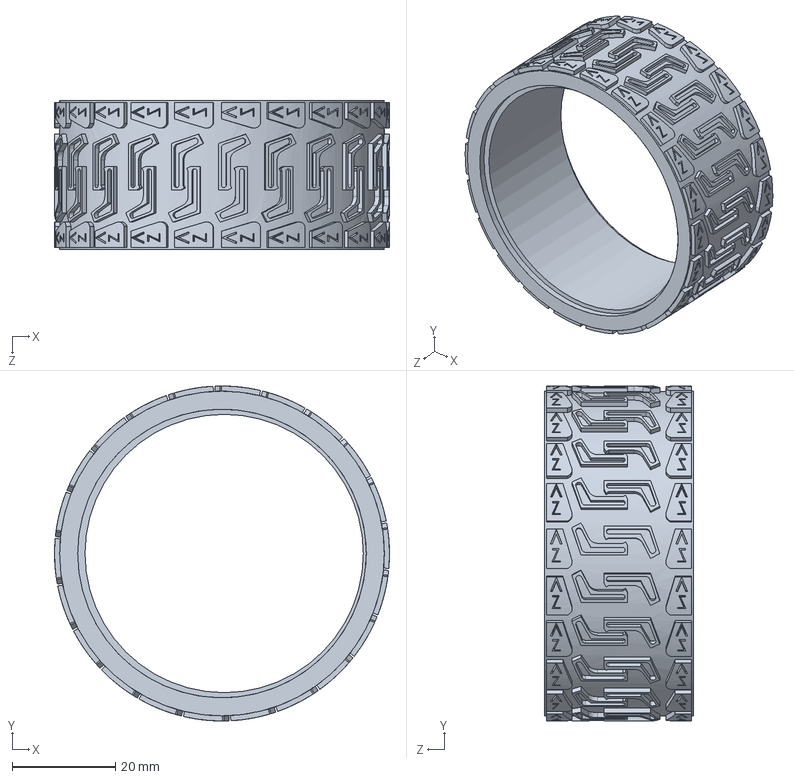
[picture p92: CAD file, 2017-12-09]
3D design/blue-wheel-for-hobby-robotics/65mm tire.SLDPRT
65.0 x 65.0 x 29.0 mm
