GabrielBS-eng/Final-Project-automation-I-/3D design/Final Design/triangular base 1.SLDPRT

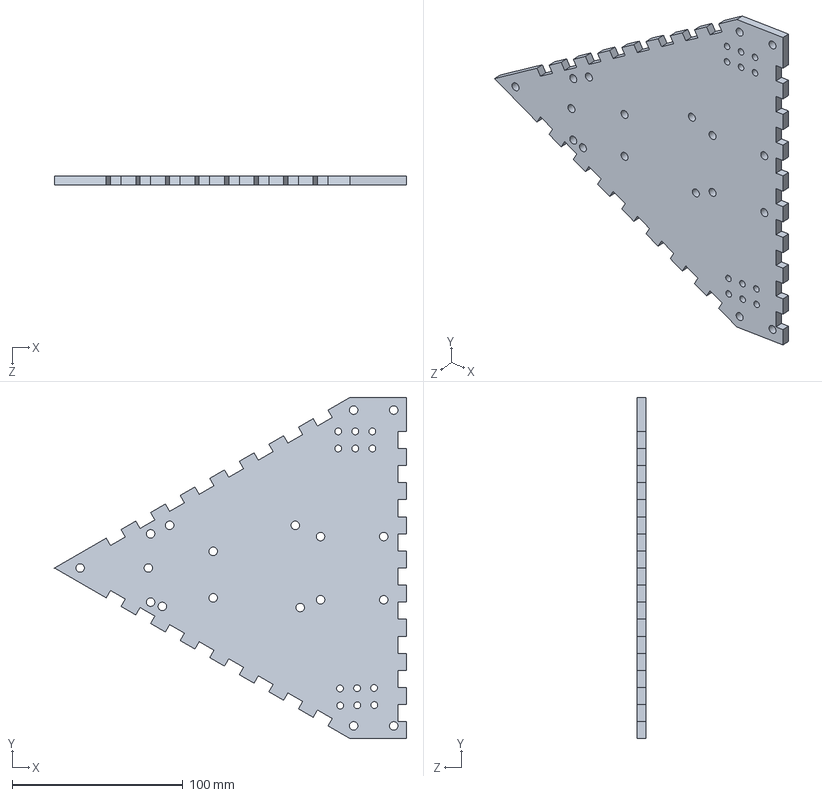
[picture p93: CAD file, 2017-12-12]
3D design/Final Design/triangular base 1.SLDPRT
206.2 x 200.0 x 5.00 mm
