GabrielBS-eng/Final-Project-automation-I-/3D design/Final Design/Walls.SLDPRT

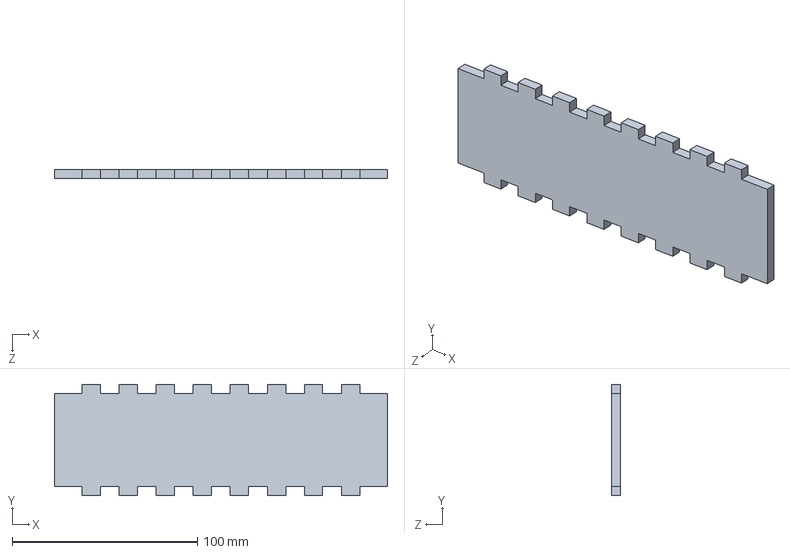
[picture p94: CAD file, 2017-12-12]
3D design/Final Design/Walls.SLDPRT
180.0 x 60.0 x 5.00 mm
