GabrielBS-eng/Final-Project-automation-I-/(list of files, cad)

Other CAD files:
3D design/ADDED/Thumb Joystick.SLDASM
3D design/4p-18650-cartridge.snapshot.1/4P_TRAY.sldprt
3D design/design draft 1/Infusion-stand.sldprt
3D design/design draft 1/Side.sldprt
3D design/design draft 1/second-base.sldprt
3D design/design draft 1/Part1.sldprt
3D design/Final Design/Addational useful laer 2x.SLDPRT
3D design/ADDED/body.SLDPRT
3D design/ADDED/joystickhead.SLDPRT
3D design/ADDED/tactileswitch-short.SLDPRT
3D design/ADDED/potentiometer.SLDPRT
3D design/4p-18650-cartridge.snapshot.1/18650.sldprt
3D design/4p-18650-cartridge.snapshot.1/4P.SLDASM
3D design/ADDED/18650.IGS
3D design/ADDED/18650.SLDPRT
3D design/ADDED/Joystick/Joystick assembly.SLDASM
3D design/ADDED/M4 x 50mm CAPHEAD BOLT.SLDPRT
3D design/ADDED/M5 x 50mm CAPHEAD BOLT.SLDPRT
3D design/ADDED/sharp 2y0a21 f 21.stl
3D design/ADDED/sharp_2y0a21_f_21.IGS
3D design/Final Design/DXF/Addational useful laer 2x.DXF
3D design/Final Design/DXF/Top layer.DXF
3D design/Final Design/DXF/the back wall.DXF
