GabrielBS-eng/Final-Project-automation-I-/MotorTFs/left_bw_step4s_0.05s_2.txt

% set_time: 50000
% delta t in s: 0.05
% START motor on: 9000
% END motor off: 13000

8399	0.00
8449	0.00
8499	0.00
8549	0.00
8599	0.00
8649	0.00
8699	0.00
8749	0.00
8799	0.00
8849	0.00
8899	0.00
8949	0.00
8999	0.00
9049	94.55
9099	201.21
9149	242.42
9199	256.97
9249	261.82
9299	266.67
9349	269.09
9399	269.09
9449	269.09
9499	271.52
9549	271.52
9600	271.52
9649	271.52
9699	269.09
9749	271.52
9799	271.52
9849	271.52
9899	273.94
9949	271.52
9999	271.52
10049	271.52
10099	271.52
10149	271.52
10199	271.52
10249	271.52
10299	271.52
10349	269.09
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
