GabrielBS-eng/Final-Project-automation-I-/MotorTFs/right_bw_step4s_0.05s_1.txt

% set_time: 50000
% delta t in s: 0.05
% START motor on: 1000
% END motor off: 5000
49	0.00
99	0.00
149	0.00
199	0.00
249	0.00
299	0.00
349	0.00
399	0.00
449	0.00
499	0.00
549	0.00
599	0.00
649	0.00
699	0.00
749	0.00
799	0.00
849	0.00
899	0.00
949	0.00
999	0.00
1049	82.42
1099	184.24
1149	223.03
1199	242.42
1249	247.27
1299	249.70
1349	249.70
1399	252.12
1449	252.12
1499	252.12
1549	252.12
1599	252.12
1649	252.12
1699	254.55
1748	254.55
1799	252.12
1849	252.12
1899	254.55
1949	252.12
1999	252.12
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
