GabrielBS-eng/Final-Project-automation-I-/MotorTFs/right_bw_step4s_0.05s_2.txt

% set_time: 50000
% delta t in s: 0.05
% START motor on: 9000
% END motor off: 13000
8049	0.00
8099	0.00
8148	0.00
8199	0.00
8249	0.00
8299	0.00
8349	0.00
8399	0.00
8449	0.00
8499	0.00
8549	0.00
8599	0.00
8649	0.00
8699	0.00
8749	0.00
8799	0.00
8849	0.00
8899	0.00
8949	0.00
8999	0.00
9049	82.42
9099	181.82
9149	223.03
9199	240.00
9249	244.85
9299	247.27
9349	249.70
9399	252.12
9449	252.12
9499	249.70
9549	249.70
9600	249.70
9649	252.12
9699	252.12
9749	252.12
9799	252.12
9849	252.12
9899	252.12
9949	252.12
9999	249.70
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
