GabrielBS-eng/Final-Project-automation-I-/MotorTFs/right_fw_step4s_0.05s_1.txt

% set_time: 50000
% delta t in s: 0.05
% START motor on: 1000
% END motor off: 5000

49	0.00
99	0.00
149	0.00
199	0.00
249	0.00
299	0.00
349	0.00
399	0.00
449	0.00
499	0.00
549	0.00
599	0.00
649	0.00
699	0.00
749	0.00
799	0.00
849	0.00
899	0.00
949	0.00
999	0.00
1049	89.70
1099	196.36
1149	237.58
1199	254.55
1249	261.82
1299	264.24
1349	266.67
1399	269.09
1449	269.09
1499	269.09
1549	269.09
1599	269.09
1649	269.09
1699	269.09
1748	269.09
1799	269.09
1849	269.09
1899	271.52
1949	269.09
1999	269.09
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
