GabrielBS-eng/Final-Project-automation-I-/MotorTFs/right_fw_step4s_0.05s_2.txt

% set_time: 50000
% delta t in s: 0.05
% START motor on: 9000
% END motor off: 13000

8499	0.00
8549	0.00
8599	0.00
8649	0.00
8699	0.00
8749	0.00
8799	0.00
8849	0.00
8899	0.00
8949	0.00
8999	0.00
9049	84.85
9099	193.94
9149	235.15
9199	252.12
9249	259.39
9299	261.82
9349	264.24
9399	264.24
9449	266.67
9499	266.67
9549	266.67
9600	264.24
9649	264.24
9699	264.24
9749	266.67
9799	266.67
9849	264.24
9899	264.24
9949	264.24
9999	266.67
10049	266.67
10099	264.24
10149	264.24
10199	264.24
10249	266.67
10299	266.67
10349	266.67
10399	266.67
10449	266.67
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
