GabrielBS-eng/Final-Project-automation-I-/MotorTFs/left_fw/left_fw_step_conresp.txt

% millis	setpoint	currentmotorspeed	pwm	pwmrestricted
0	200.00	0.00	255.00	255
6	200.00	0.00	255.00	255
12	200.00	0.00	255.00	255
19	200.00	0.00	255.00	255
43	200.00	0.00	255.00	255
70	200.00	0.00	255.00	255
97	200.00	135.76	255.00	255
126	200.00	135.76	54.06	54
154	200.00	135.76	54.06	54
182	200.00	135.76	54.06	54
210	200.00	208.48	54.06	54
238	200.00	208.48	0.00	0
265	200.00	208.48	0.00	0
290	200.00	208.48	0.00	0
316	200.00	189.09	0.00	0
343	200.00	189.09	178.48	178
372	200.00	189.09	178.48	178
403	200.00	173.33	178.48	178
433	200.00	173.33	178.48	178
463	200.00	173.33	219.06	219
493	200.00	204.85	219.06	219
523	200.00	204.85	219.06	219
553	200.00	204.85	219.06	219
583	200.00	204.85	77.44	77
612	200.00	224.24	77.44	77
640	200.00	224.24	77.44	77
668	200.00	224.24	77.44	77
696	200.00	214.55	43.21	43
723	200.00	214.55	43.21	43
752	200.00	214.55	43.21	43
780	200.00	214.55	43.21	43
808	200.00	195.15	181.51	181
838	200.00	195.15	181.51	181
869	200.00	195.15	181.51	181
899	200.00	196.36	181.51	181
929	200.00	196.36	134.37	134
959	200.00	196.36	134.37	134
989	200.00	196.36	134.37	134
1019	200.00	214.55	134.37	134
1050	200.00	214.55	62.86	62
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
