GabrielBS-eng/Final-Project-automation-I-/MotorTFs/left_fw/left_fw_step4s_0.05s_1.txt

% set_time: 50000
% delta t in s: 0.05
% START motor on: 1000
% END motor off: 5000

699	0.00
749	0.00
799	0.00
849	0.00
899	0.00
949	0.00
999	0.00
1049	92.12
1099	193.94
1149	230.30
1199	247.27
1249	252.12
1299	254.55
1349	254.55
1399	254.55
1449	256.97
1499	259.39
1549	259.39
1599	259.39
1649	256.97
1699	259.39
1748	259.39
1799	259.39
1849	259.39
1899	259.39
1949	259.39
1999	259.39
2049	259.39
2099	264.24
2149	261.82
2199	261.82
2249	261.82
2299	261.82
2349	261.82
2399	261.82
2449	264.24
2499	261.82
2549	261.82
2599	261.82
2649	261.82
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
