GabrielBS-eng/Final-Project-automation-I-/MotorTFs/left_fw/left_fw_step4s_0.05s_2.txt

% set_time: 50000
% delta t in s: 0.05
% START motor on: 9000
% END motor off: 13000

8649	0.00
8699	0.00
8749	0.00
8799	0.00
8849	0.00
8899	0.00
8949	0.00
8999	0.00
9049	89.70
9099	198.79
9149	235.15
9199	247.27
9249	254.55
9299	259.39
9349	259.39
9399	259.39
9449	259.39
9499	259.39
9549	261.82
9600	261.82
9649	261.82
9699	261.82
9749	264.24
9799	261.82
9849	261.82
9899	261.82
9949	261.82
9999	264.24
10049	264.24
10099	261.82
10149	261.82
10199	261.82
10249	261.82
10299	261.82
10349	261.82
10399	261.82
10449	264.24
10499	264.24
10549	264.24
10599	264.24
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
