GabrielBS-eng/Final-Project-automation-I-/MotorTFs/left_fw/ContrlTest.txt

6	200.00	0.00	255.00	255
12	200.00	0.00	255.00	255
19	200.00	0.00	255.00	255
43	200.00	0.00	255.00	255
70	200.00	0.00	255.00	255
97	200.00	149.09	255.00	255
126	200.00	149.09	255.00	255
156	200.00	149.09	255.00	255
186	200.00	149.09	255.00	255
217	200.00	250.91	255.00	255
246	200.00	250.91	133.59	133
277	200.00	250.91	133.59	133
307	200.00	264.24	133.59	133
337	200.00	264.24	133.59	133
367	200.00	264.24	36.06	36
396	200.00	250.91	36.06	36
423	200.00	250.91	36.06	36
451	200.00	250.91	36.06	36
480	200.00	250.91	0.00	0
505	200.00	223.03	0.00	0
532	200.00	223.03	0.00	0
558	200.00	223.03	0.00	0
583	200.00	223.03	0.00	0
610	200.00	189.09	0.00	0
635	200.00	189.09	0.00	0
661	200.00	189.09	0.00	0
688	200.00	189.09	36.85	36
715	200.00	153.94	36.85	36
744	200.00	153.94	36.85	36
772	200.00	153.94	36.85	36
800	200.00	132.12	186.80	186
830	200.00	132.12	186.80	186
860	200.00	132.12	186.80	186
890	200.00	132.12	186.80	186
920	200.00	176.97	167.50	167
951	200.00	176.97	167.50	167
980	200.00	176.97	167.50	167
1011	200.00	230.30	167.50	167
1042	200.00	230.30	70.04	70
1072	200.00	230.30	70.04	70
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
