GabrielBS-eng/Final-Project-automation-I-/MotorTFs/left_fw/ContrTest2.txt

%double kpL = 0.3, kiL = 3.9423, kdL = 0;

505	200.00	0.00	138.85	138
513	200.00	0.00	138.85	138
521	200.00	0.00	138.85	138
549	200.00	0.00	138.85	138
577	200.00	0.00	138.85	138
606	200.00	86.06	157.95	157
634	200.00	86.06	157.95	157
663	200.00	86.06	157.95	157
693	200.00	184.24	157.95	157
722	200.00	184.24	134.70	134
753	200.00	184.24	134.70	134
783	200.00	184.24	134.70	134
814	200.00	225.45	134.70	134
843	200.00	225.45	112.31	112
874	200.00	225.45	112.31	112
904	200.00	235.15	112.31	112
934	200.00	235.15	112.31	112
964	200.00	235.15	95.54	95
992	200.00	235.15	95.54	95
1020	200.00	236.36	95.54	95
1049	200.00	236.36	95.54	95
1079	200.00	236.36	80.84	80
1107	200.00	231.52	80.84	80
1137	200.00	231.52	80.84	80
1166	200.00	231.52	80.84	80
1196	200.00	224.24	69.87	69
1224	200.00	224.24	69.87	69
1253	200.00	224.24	69.87	69
1283	200.00	224.24	69.87	69
1311	200.00	215.76	68.38	68
1341	200.00	215.76	68.38	68
1370	200.00	215.76	68.38	68
1398	200.00	207.27	68.38	68
1428	200.00	207.27	68.06	68
1457	200.00	207.27	68.06	68
1486	200.00	207.27	68.06	68
1515	200.00	202.42	68.06	68
1545	200.00	202.42	68.56	68
1573	200.00	202.42	68.56	68
1603	200.00	197.58	68.56	68
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
