GabrielBS-eng/Final-Project-automation-I-/MotorTFs/left_fw/ContrTest3.txt

%double kpL = 0.28, kiL = 3.5, kdL = 0;

499	200.00	0.00	126.00	126
505	200.00	0.00	126.00	126
513	200.00	0.00	126.00	126
521	200.00	0.00	126.00	126
549	200.00	0.00	126.00	126
577	200.00	0.00	126.00	126
606	200.00	75.15	148.65	148
634	200.00	75.15	148.65	148
663	200.00	75.15	148.65	148
693	200.00	168.48	148.65	148
722	200.00	168.48	133.55	133
753	200.00	168.48	133.55	133
783	200.00	168.48	133.55	133
814	200.00	210.91	133.55	133
843	200.00	210.91	117.85	117
874	200.00	210.91	117.85	117
904	200.00	225.45	117.85	117
934	200.00	225.45	117.85	117
964	200.00	225.45	104.87	104
994	200.00	226.67	104.87	104
1025	200.00	226.67	104.87	104
1055	200.00	226.67	104.87	104
1087	200.00	226.67	95.20	95
1116	200.00	225.45	95.20	95
1145	200.00	225.45	95.20	95
1174	200.00	225.45	95.20	95
1204	200.00	221.82	88.92	88
1232	200.00	221.82	88.92	88
1261	200.00	221.82	88.92	88
1291	200.00	221.82	88.92	88
1319	200.00	216.97	84.34	84
1349	200.00	216.97	84.34	84
1378	200.00	216.97	84.34	84
1408	200.00	210.91	84.34	84
1436	200.00	210.91	82.22	82
1465	200.00	210.91	82.22	82
1495	200.00	208.48	82.22	82
1523	200.00	208.48	82.22	82
1553	200.00	208.48	79.93	79
1582	200.00	208.48	79.93	79
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
