GabrielBS-eng/Final-Project-automation-I-/MotorTFs/left_fw/ContrTest4.txt

%double kpL = 0.25, kiL = 3.5, kdL = 0;
499	200.00	0.00	120.00	120
505	200.00	0.00	120.00	120
513	200.00	0.00	120.00	120
521	200.00	0.00	120.00	120
549	200.00	0.00	120.00	120
577	200.00	0.00	120.00	120
606	200.00	71.52	147.09	147
634	200.00	71.52	147.09	147
663	200.00	71.52	147.09	147
693	200.00	164.85	147.09	147
722	200.00	164.85	136.06	136
753	200.00	164.85	136.06	136
783	200.00	164.85	136.06	136
814	200.00	208.48	136.06	136
843	200.00	208.48	122.18	122
874	200.00	208.48	122.18	122
904	200.00	224.24	122.18	122
934	200.00	224.24	122.18	122
964	200.00	224.24	109.76	109
994	200.00	226.67	109.76	109
1025	200.00	226.67	109.76	109
1055	200.00	226.67	109.76	109
1087	200.00	226.67	99.82	99
1116	200.00	226.67	99.82	99
1145	200.00	226.67	99.82	99
1174	200.00	226.67	99.82	99
1204	200.00	221.82	93.39	93
1232	200.00	221.82	93.39	93
1261	200.00	221.82	93.39	93
1291	200.00	221.82	93.39	93
1319	200.00	216.97	88.67	88
1349	200.00	216.97	88.67	88
1378	200.00	216.97	88.67	88
1408	200.00	212.12	88.67	88
1436	200.00	212.12	85.64	85
1465	200.00	212.12	85.64	85
1495	200.00	208.48	85.64	85
1523	200.00	208.48	85.64	85
1553	200.00	208.48	83.58	83
1582	200.00	208.48	83.58	83
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
