GabrielBS-eng/Final-Project-automation-I-/MotorTFs/left_fw/ContrTest6.txt

%double kpL = 0.15, kiL = 3.5, kdL = 0;
499	200.00	0.00	100.00	100
505	200.00	0.00	100.00	100
513	200.00	0.00	100.00	100
521	200.00	0.00	100.00	100
549	200.00	0.00	100.00	100
577	200.00	0.00	100.00	100
606	200.00	56.97	141.52	141
634	200.00	56.97	141.52	141
663	200.00	56.97	141.52	141
693	200.00	147.88	141.52	141
722	200.00	147.88	146.12	146
753	200.00	147.88	146.12	146
783	200.00	147.88	146.12	146
814	200.00	203.64	146.12	146
843	200.00	203.64	136.48	136
874	200.00	203.64	136.48	136
904	200.00	229.09	136.48	136
934	200.00	229.09	136.48	136
964	200.00	229.09	122.48	122
994	200.00	238.79	122.48	122
1025	200.00	238.79	122.48	122
1055	200.00	238.79	122.48	122
1087	200.00	238.79	107.45	107
1118	200.00	237.58	107.45	107
1149	200.00	237.58	107.45	107
1180	200.00	237.58	107.45	107
1212	200.00	233.94	96.30	96
1241	200.00	233.94	96.30	96
1270	200.00	233.94	96.30	96
1299	200.00	230.30	96.30	96
1329	200.00	230.30	86.24	86
1357	200.00	230.30	86.24	86
1386	200.00	230.30	86.24	86
1416	200.00	224.24	86.24	86
1444	200.00	224.24	78.67	78
1474	200.00	224.24	78.67	78
1503	200.00	216.97	78.67	78
1531	200.00	216.97	78.67	78
1561	200.00	216.97	73.82	73
1590	200.00	216.97	73.82	73
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
