GabrielBS-eng/Final-Project-automation-I-/MotorTFs/left_fw/ContrTestMahmoud.txt

%double kpL = 0.17, kiL = 4.402, kdL = 0;

6	200.00	0.00	122.04	122
12	200.00	0.00	122.04	122
19	200.00	0.00	122.04	122
43	200.00	0.00	122.04	122
70	200.00	0.00	122.04	122
97	200.00	73.94	122.04	122
125	200.00	73.94	164.96	164
154	200.00	73.94	164.96	164
183	200.00	73.94	164.96	164
212	200.00	167.27	164.96	164
242	200.00	167.27	163.50	163
273	200.00	167.27	163.50	163
303	200.00	218.18	163.50	163
333	200.00	218.18	163.50	163
363	200.00	218.18	146.84	146
393	200.00	237.58	146.84	146
423	200.00	237.58	146.84	146
453	200.00	237.58	146.84	146
484	200.00	237.58	127.01	127
514	200.00	242.42	127.01	127
544	200.00	242.42	127.01	127
574	200.00	242.42	127.01	127
605	200.00	238.79	109.73	109
634	200.00	238.79	109.73	109
665	200.00	238.79	109.73	109
695	200.00	233.94	109.73	109
726	200.00	233.94	95.61	95
753	200.00	233.94	95.61	95
781	200.00	233.94	95.61	95
809	200.00	227.88	95.61	95
837	200.00	227.88	84.37	84
866	200.00	227.88	84.37	84
893	200.00	218.18	84.37	84
921	200.00	218.18	84.37	84
950	200.00	218.18	78.01	78
977	200.00	218.18	78.01	78
1006	200.00	210.91	78.01	78
1035	200.00	210.91	78.01	78
1064	200.00	210.91	74.45	74
1093	200.00	202.42	74.45	74
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
