GabrielBS-eng/Final-Project-automation-I-/(list of files, drawings)

Other design files:
Code/Encoder test/Identification/Ident Proteus/Ident Proteus.pdsprj
