GabrielBS-eng/Final-Project-automation-I-/(commit log)

2017-12-09 sketch of the base
    [AssemFinalProject-2.SLDASM, triangular-base.sldprt]
2017-12-10 Some updates of the design
    [AssemFinalProject-2.SLDASM, second-base.sldprt, triangular-base.sldprt]
2017-12-10 More design updates
    [AssemFinalProject-2.SLDASM, Infusion-stand.sldprt, Side.sldprt]
2017-12-11 Final Design
    [Addational useful laer 2x.DXF, Addational useful laer 2x.SLDPRT, Addational useful laer.SLDPRT, Addational useful layer 2 2x.DXF, Addational useful layer 2.SLDPRT, Assem1.SLDASM, Assem2.SLDASM, AssemFinalProject-2.SLDASM]
2017-12-12 encoder working now
    [Data .xlsx, Ident Proteus.pdsprj]
2017-12-15 Code for motor control
2017-12-15 Schematic Overview + Code
2017-12-16 Determination Controller for Left Wheel Forward
2017-12-16 update motor control
2017-12-16 Update last code. Printing pwm for both motors.
2017-12-16 printing encoder now
